crgmakes/kicad-library/models/PinHeader_2x02_P1.27mm_Vertical_SMD.step

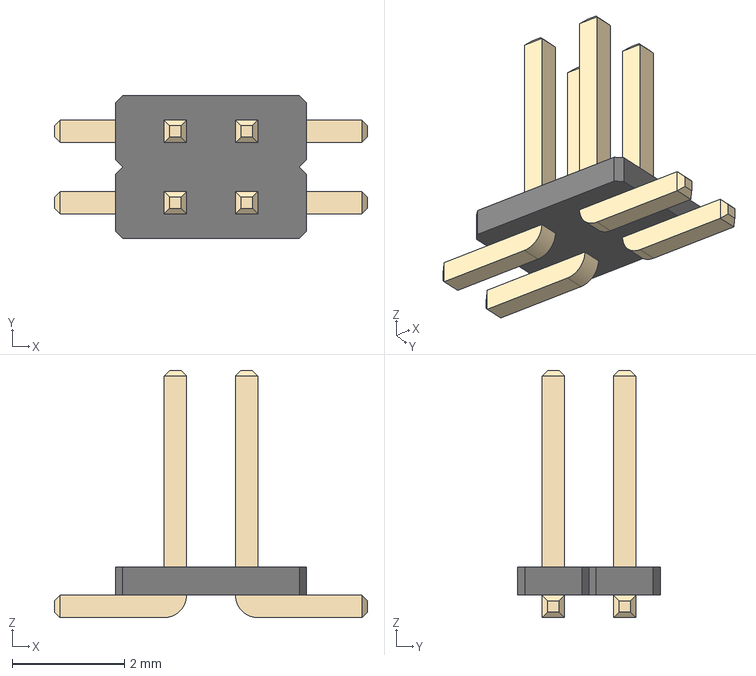
[picture p10: CAD file, 2026-08-05]
models/PinHeader_2x02_P1.27mm_Vertical_SMD.step
5.57 x 2.54 x 4.40 mm
