crgmakes/kicad-library/models/C_1210_3225Metric.step

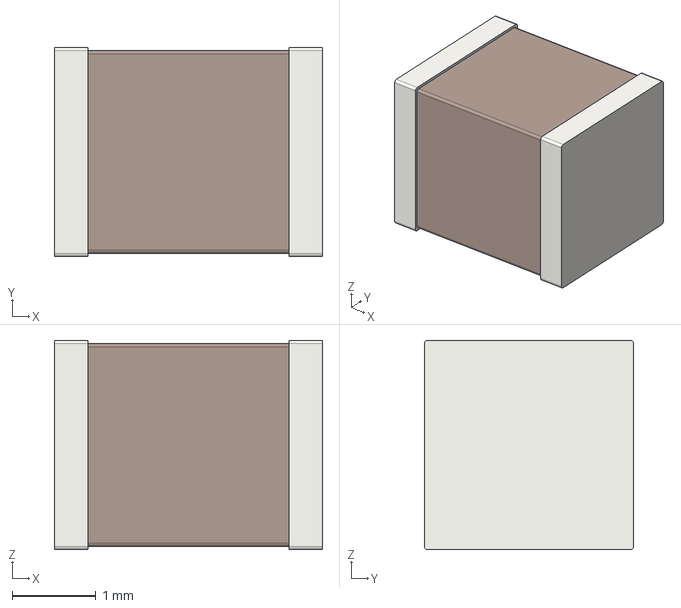
[picture p11: CAD file, 2026-07-14]
models/C_1210_3225Metric.step
3.20 x 2.50 x 2.50 mm
