crgmakes/kicad-library/models/C_0402_1005Metric.step

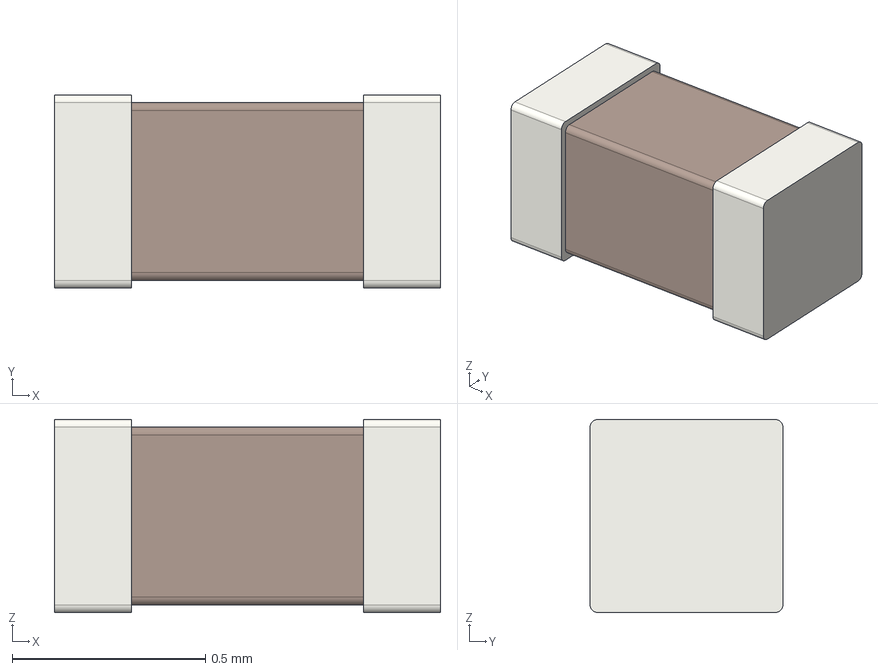
[picture p12: CAD file, 2026-07-14]
models/C_0402_1005Metric.step
1.00 x 0.5 x 0.5 mm
