crgmakes/kicad-library/models/C_0805_2012Metric.step

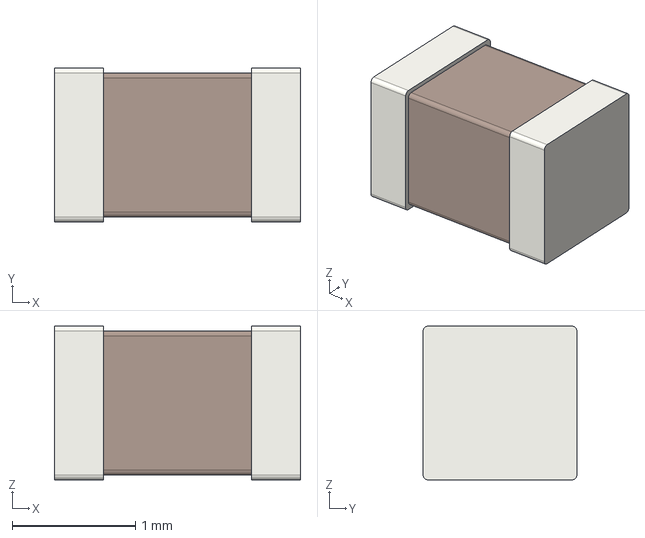
[picture p13: CAD file, 2026-07-14]
models/C_0805_2012Metric.step
2.00 x 1.25 x 1.25 mm
