crgmakes/kicad-library/models/SOIC-14_3.9x8.7mm_P1.27mm.step

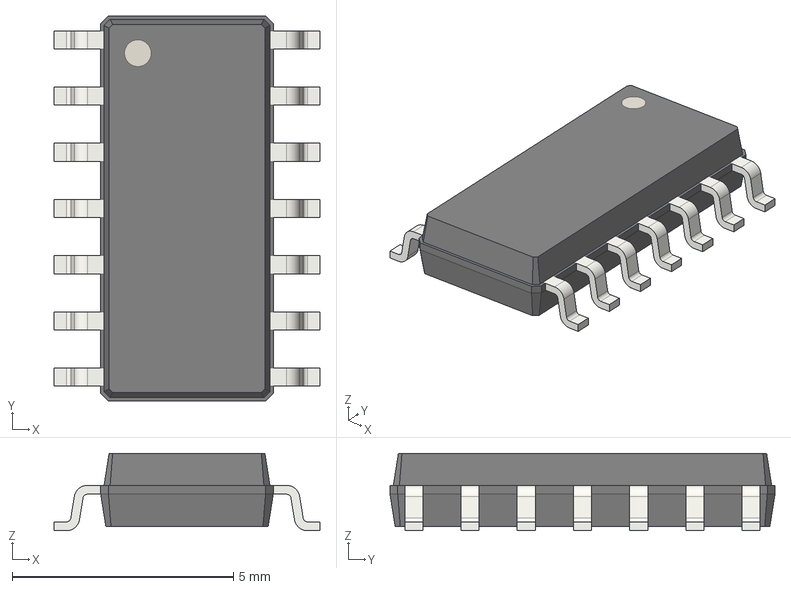
[picture p14: CAD file, 2026-06-17]
models/SOIC-14_3.9x8.7mm_P1.27mm.step
6.00 x 8.70 x 1.75 mm
