crgmakes/kicad-library/models/D_SOD-323F.step

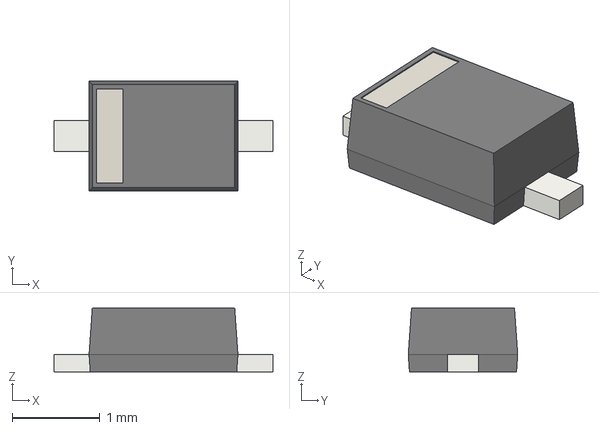
[picture p15: CAD file, 2026-06-17]
models/D_SOD-323F.step
2.50 x 1.25 x 0.73 mm
