crgmakes/kicad-library/models/Crystal_SMD_2016-4Pin_2.0x1.6mm.step

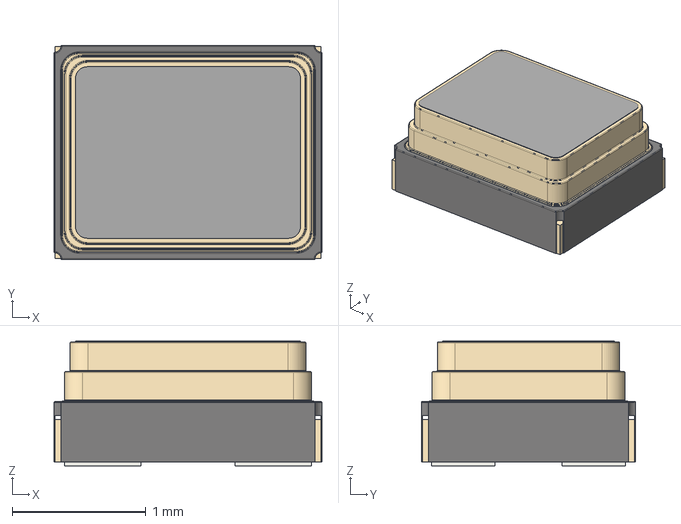
[picture p16: CAD file, 2026-06-13]
models/Crystal_SMD_2016-4Pin_2.0x1.6mm.step
2.00 x 1.60 x 0.93 mm
