crgmakes/kicad-library/models/ECS-480-8-47-JTN-TR.step

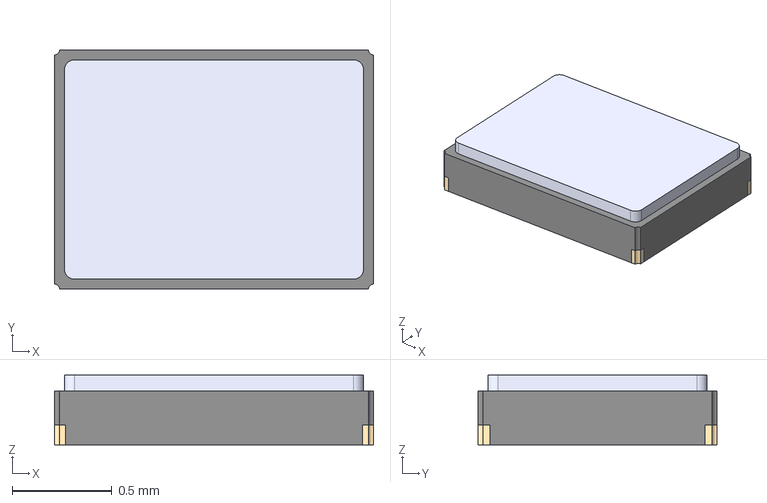
[picture p17: CAD file, 2026-06-13]
models/ECS-480-8-47-JTN-TR.step
1.60 x 1.20 x 0.35 mm
