crgmakes/kicad-library/models/STM32C031G4U6.step

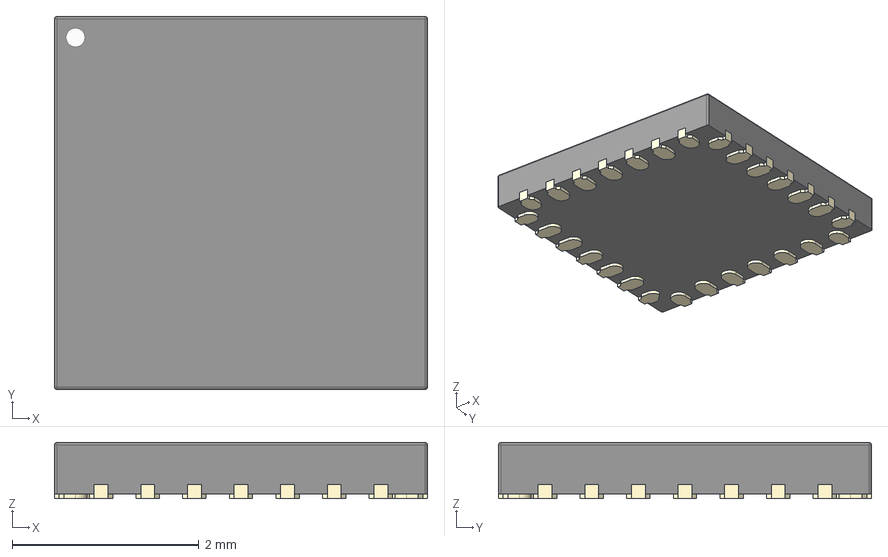
[picture p18: CAD file, 2026-06-13]
models/STM32C031G4U6.step
4.00 x 4.00 x 0.601 mm
