crgmakes/kicad-library/models/JST_SH_BM09B-SRSS-TB_1x09-1MP_P1.00mm_Vertical.step

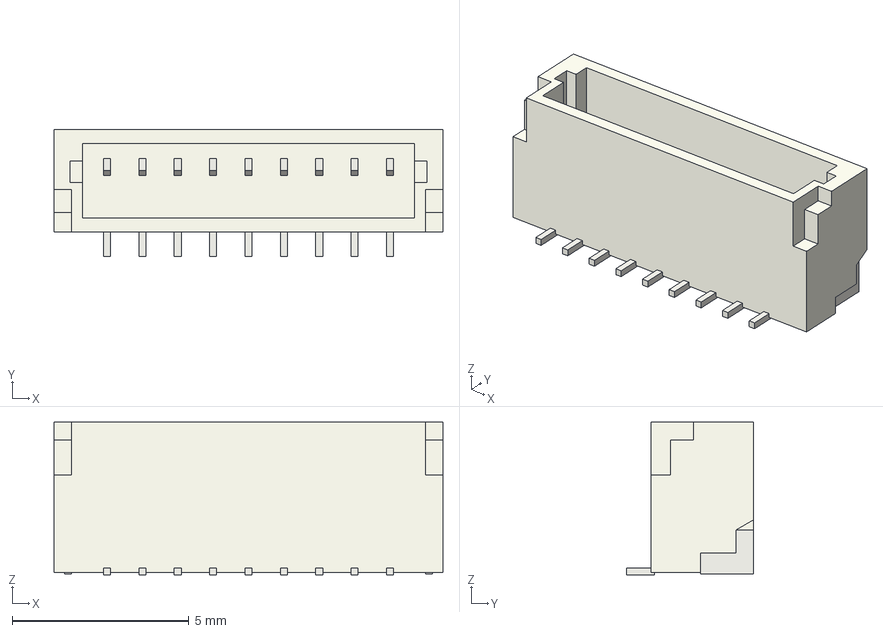
[picture p19: CAD file, 2026-06-10]
models/JST_SH_BM09B-SRSS-TB_1x09-1MP_P1.00mm_Vertical.step
11.0 x 3.60 x 4.32 mm
