crgmakes/kicad-library/models/LED_0603_1608Metric.step

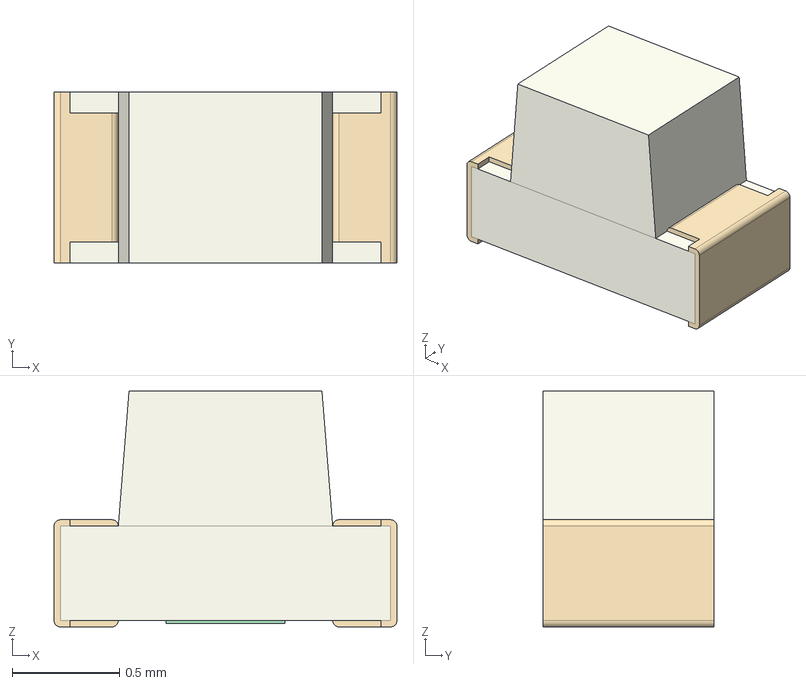
[picture p20: CAD file, 2026-06-10]
models/LED_0603_1608Metric.step
1.60 x 0.8 x 1.10 mm
