crgmakes/kicad-library/models/JST_SH_SM02B-SRSS-TB_1x02-1MP_P1.00mm_Horizontal.step

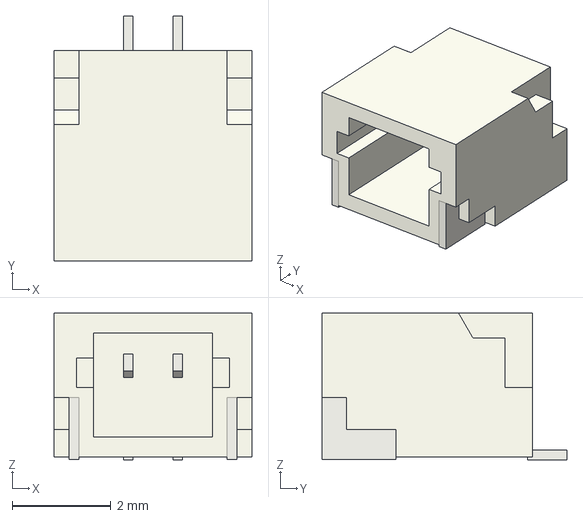
[picture p21: CAD file, 2026-06-10]
models/JST_SH_SM02B-SRSS-TB_1x02-1MP_P1.00mm_Horizontal.step
4.00 x 4.95 x 2.96 mm
