crgmakes/kicad-library/models/PinHeader_2x05_P2.54mm_Vertical.step

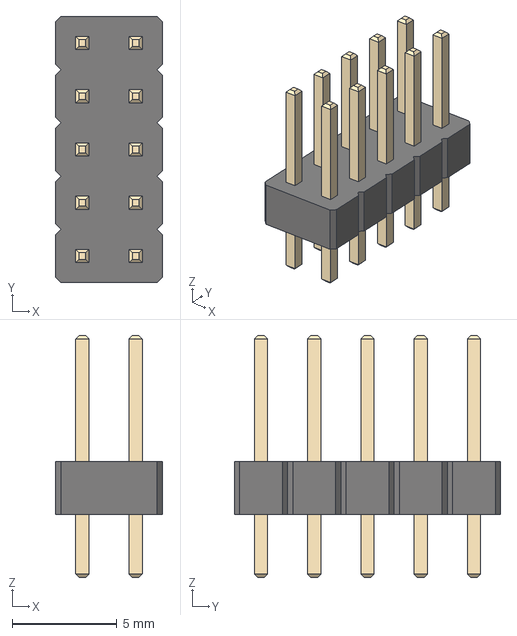
[picture p22: CAD file, 2026-06-10]
models/PinHeader_2x05_P2.54mm_Vertical.step
5.08 x 12.7 x 11.5 mm
