crgmakes/kicad-library/models/JST_SH_SM08B-SRSS-TB_1x08-1MP_P1.00mm_Horizontal.step

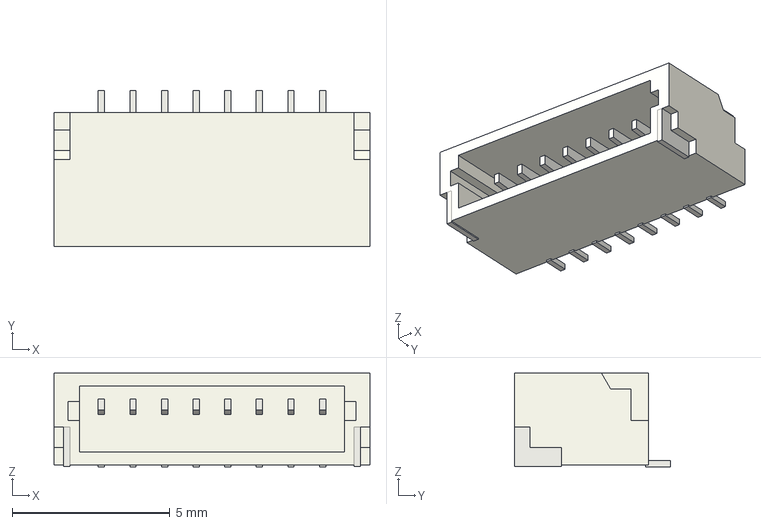
[picture p23: CAD file, 2026-06-10]
models/JST_SH_SM08B-SRSS-TB_1x08-1MP_P1.00mm_Horizontal.step
10.0 x 4.95 x 2.96 mm
