crgmakes/kicad-library/models/JST_SH_SM12B-SRSS-TB_1x12-1MP_P1.00mm_Horizontal.step

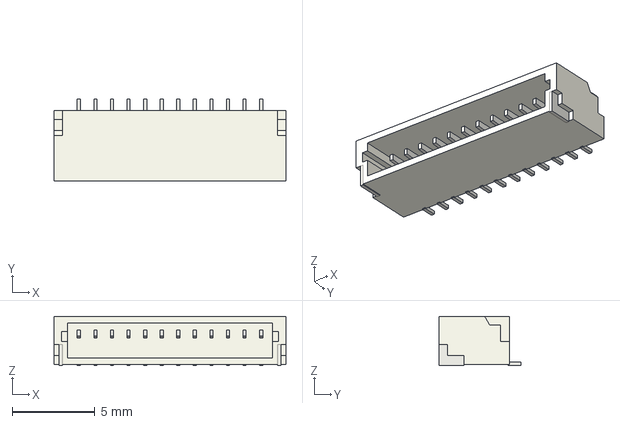
[picture p24: CAD file, 2026-06-10]
models/JST_SH_SM12B-SRSS-TB_1x12-1MP_P1.00mm_Horizontal.step
14.0 x 4.95 x 2.96 mm
