crgmakes/kicad-library/models/PinHeader_2x05_P1.27mm_Vertical.step

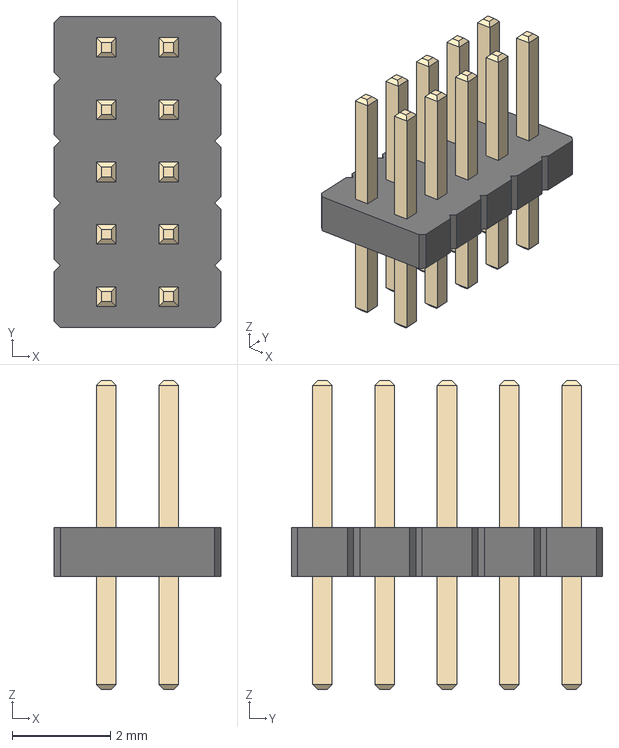
[picture p25: CAD file, 2026-06-10]
models/PinHeader_2x05_P1.27mm_Vertical.step
3.40 x 6.35 x 6.30 mm
