crgmakes/kicad-library/models/JST_SH_SM10B-SRSS-TB_1x10-1MP_P1.00mm_Horizontal.step

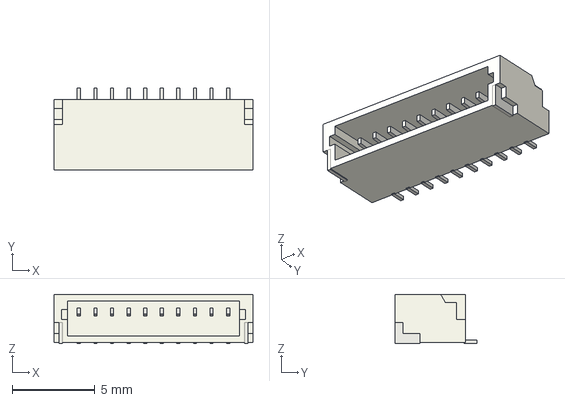
[picture p26: CAD file, 2026-06-10]
models/JST_SH_SM10B-SRSS-TB_1x10-1MP_P1.00mm_Horizontal.step
12.0 x 4.95 x 2.96 mm
