crgmakes/kicad-library/models/JST_SH_SM14B-SRSS-TB_1x14-1MP_P1.00mm_Horizontal.step

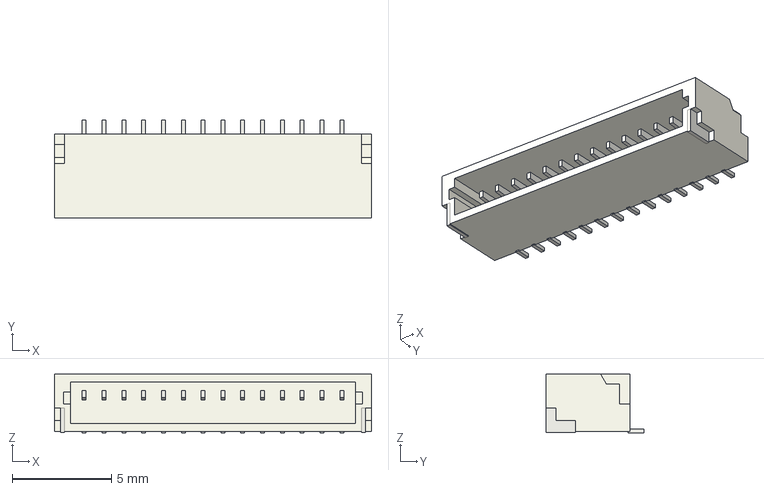
[picture p27: CAD file, 2026-06-10]
models/JST_SH_SM14B-SRSS-TB_1x14-1MP_P1.00mm_Horizontal.step
16.0 x 4.95 x 2.96 mm
