crgmakes/kicad-library/models/JST_SH_SM09B-SRSS-TB_1x09-1MP_P1.00mm_Horizontal.step

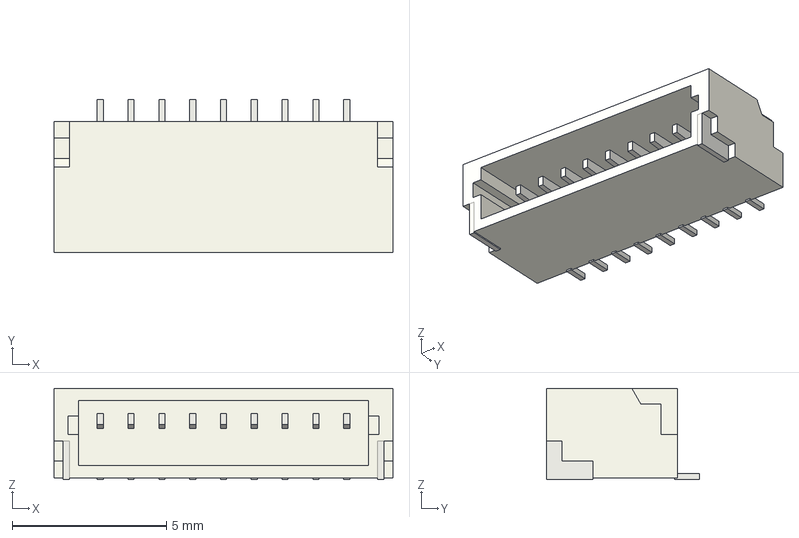
[picture p29: CAD file, 2026-06-10]
models/JST_SH_SM09B-SRSS-TB_1x09-1MP_P1.00mm_Horizontal.step
11.0 x 4.95 x 2.96 mm
