crgmakes/kicad-library/models/R_0603_1608Metric.step

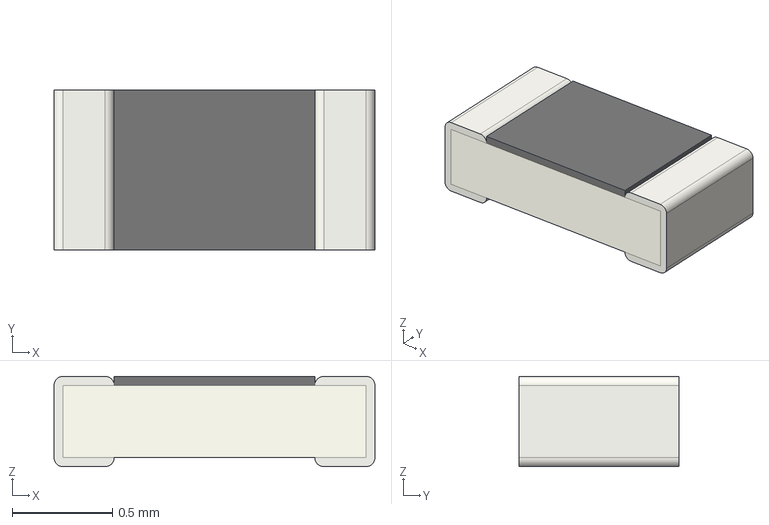
[picture p30: CAD file, 2026-06-10]
models/R_0603_1608Metric.step
1.60 x 0.8 x 0.45 mm
