crgmakes/kicad-library/models/JST_SH_BM06B-SRSS-TB_1x06-1MP_P1.00mm_Vertical.step

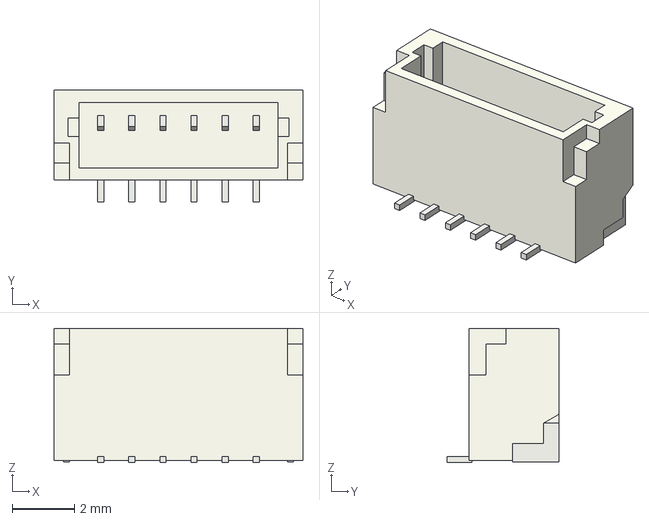
[picture p31: CAD file, 2026-06-10]
models/JST_SH_BM06B-SRSS-TB_1x06-1MP_P1.00mm_Vertical.step
8.00 x 3.60 x 4.32 mm
