crgmakes/kicad-library/models/PinHeader_2x05_P1.27mm_Vertical_SMD.step

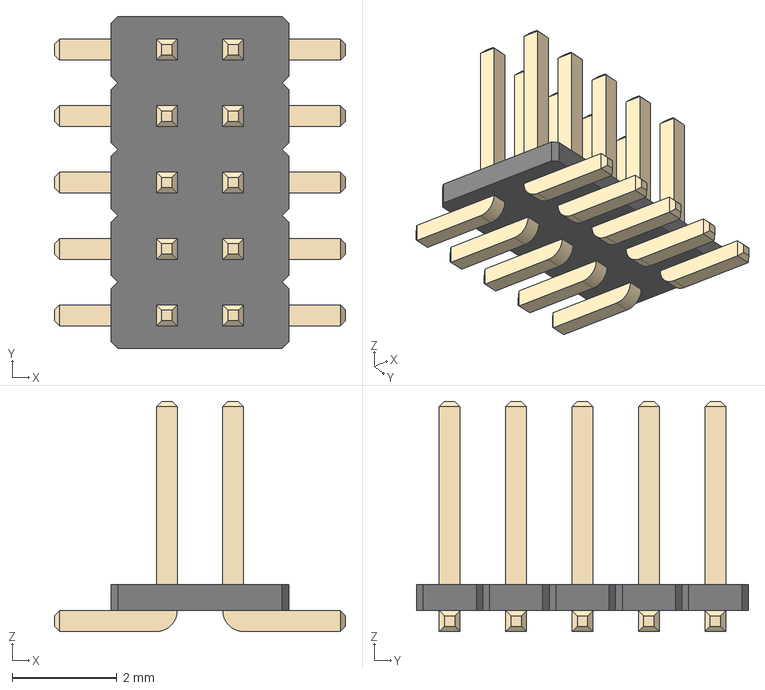
[picture p32: CAD file, 2026-06-10]
models/PinHeader_2x05_P1.27mm_Vertical_SMD.step
5.57 x 6.35 x 4.40 mm
