crgmakes/kicad-library/models/JST_SH_BM05B-SRSS-TB_1x05-1MP_P1.00mm_Vertical.step

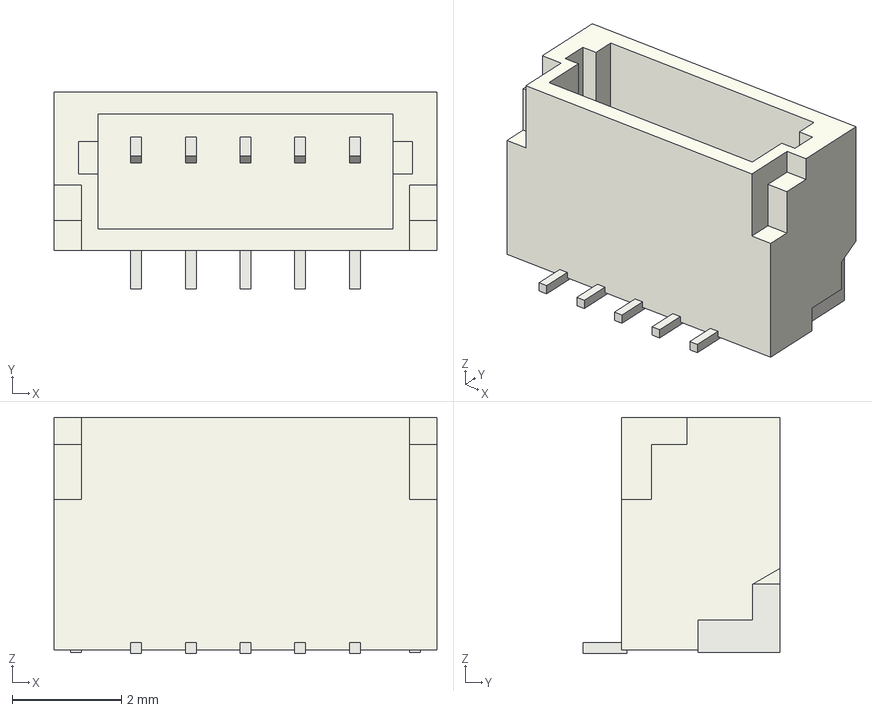
[picture p33: CAD file, 2026-06-10]
models/JST_SH_BM05B-SRSS-TB_1x05-1MP_P1.00mm_Vertical.step
7.00 x 3.60 x 4.32 mm
