crgmakes/kicad-library/models/CP_Elec_5x5.4.step

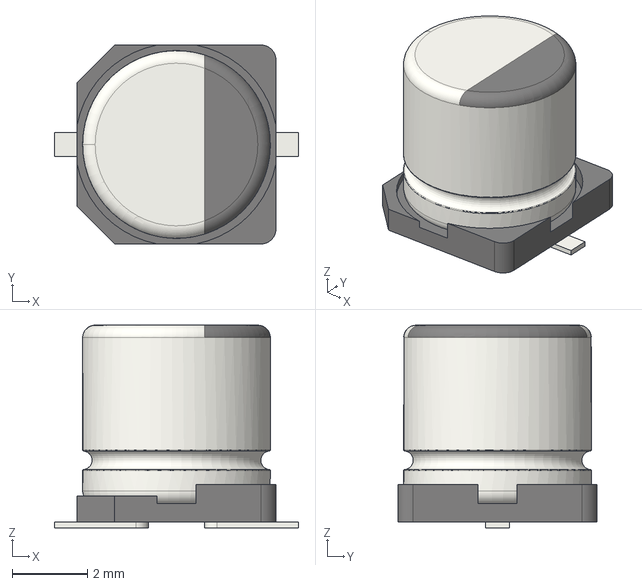
[picture p34: CAD file, 2026-06-10]
models/CP_Elec_5x5.4.step
6.50 x 5.30 x 5.40 mm
