crgmakes/kicad-library/models/PinHeader_2x05_P2.54mm_Vertical_SMD.step

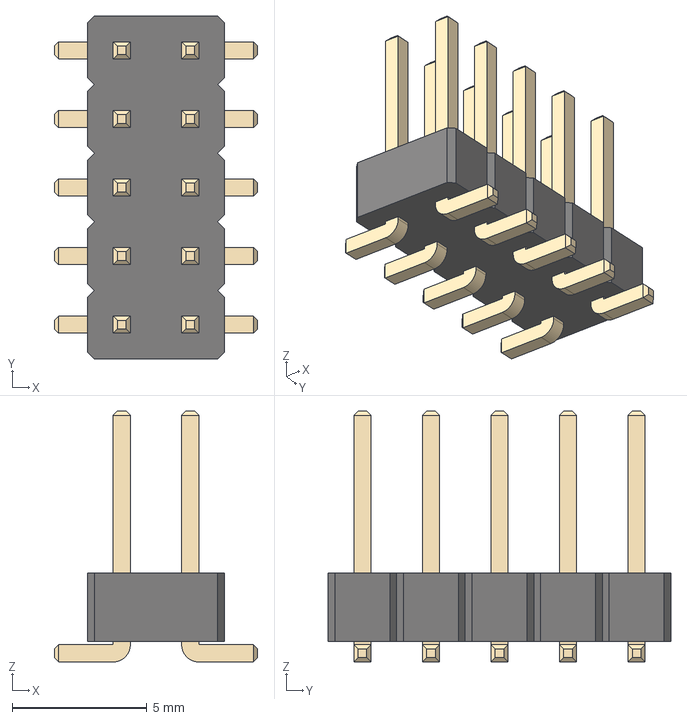
[picture p35: CAD file, 2026-06-10]
models/PinHeader_2x05_P2.54mm_Vertical_SMD.step
7.54 x 12.7 x 9.30 mm
