crgmakes/kicad-library/models/JST_SH_BM10B-SRSS-TB_1x10-1MP_P1.00mm_Vertical.step

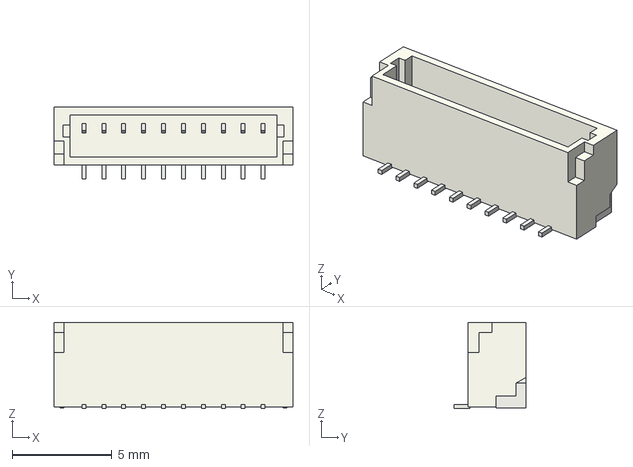
[picture p36: CAD file, 2026-06-10]
models/JST_SH_BM10B-SRSS-TB_1x10-1MP_P1.00mm_Vertical.step
12.0 x 3.60 x 4.32 mm
