crgmakes/kicad-library/models/C_0603_1608Metric.step

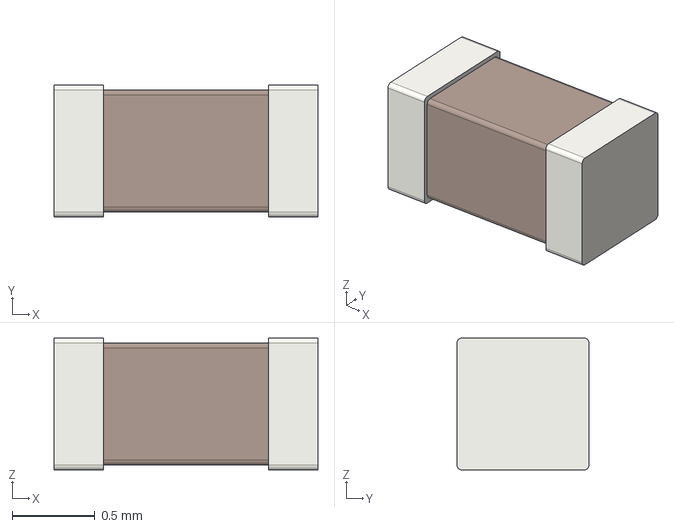
[picture p37: CAD file, 2026-06-10]
models/C_0603_1608Metric.step
1.60 x 0.8 x 0.8 mm
