crgmakes/kicad-library/models/JST_SH_BM04B-SRSS-TB_1x04-1MP_P1.00mm_Vertical.step

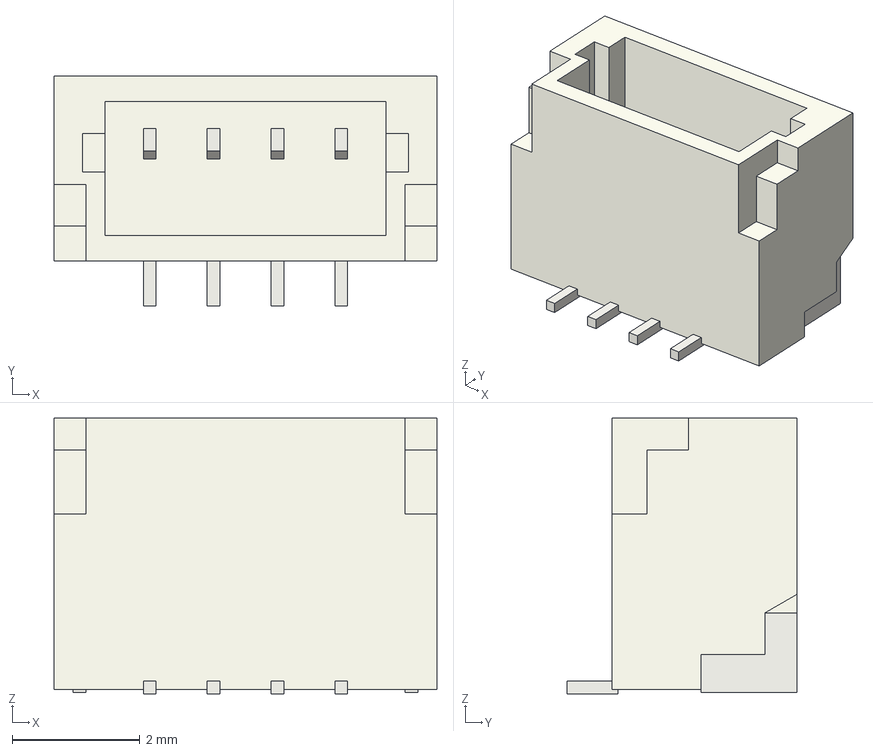
[picture p38: CAD file, 2026-06-10]
models/JST_SH_BM04B-SRSS-TB_1x04-1MP_P1.00mm_Vertical.step
6.00 x 3.60 x 4.32 mm
