crgmakes/kicad-library/models/PinHeader_2x03_P2.54mm_Vertical.step

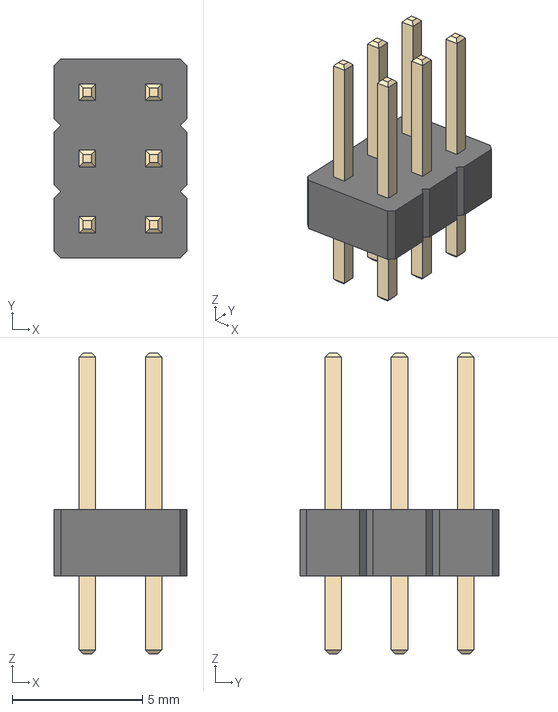
[picture p39: CAD file, 2026-06-10]
models/PinHeader_2x03_P2.54mm_Vertical.step
5.08 x 7.62 x 11.5 mm
