crgmakes/kicad-library/models/JST_SH_SM07B-SRSS-TB_1x07-1MP_P1.00mm_Horizontal.step

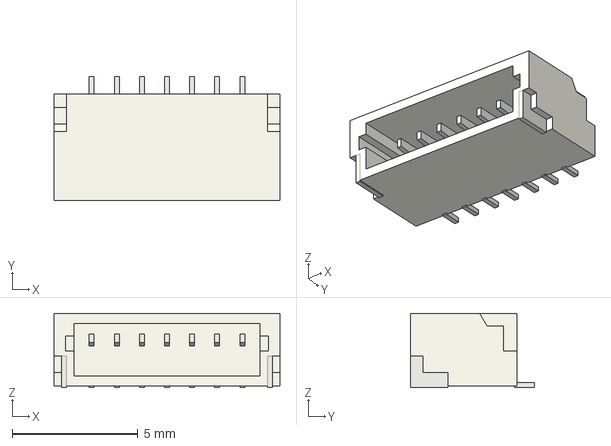
[picture p40: CAD file, 2026-06-10]
models/JST_SH_SM07B-SRSS-TB_1x07-1MP_P1.00mm_Horizontal.step
9.00 x 4.95 x 2.96 mm
