crgmakes/kicad-library/models/JST_SH_BM11B-SRSS-TB_1x11-1MP_P1.00mm_Vertical.step

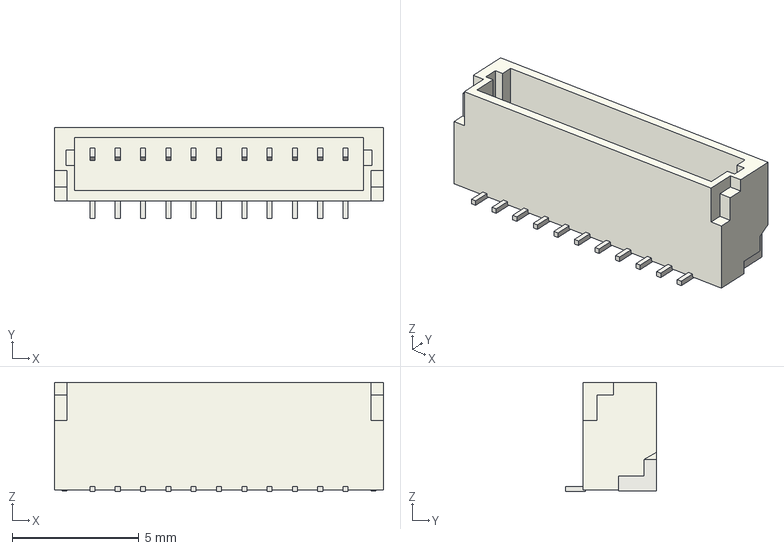
[picture p41: CAD file, 2026-06-10]
models/JST_SH_BM11B-SRSS-TB_1x11-1MP_P1.00mm_Vertical.step
13.0 x 3.60 x 4.32 mm
