crgmakes/kicad-library/models/JST_SH_BM02B-SRSS-TB_1x02-1MP_P1.00mm_Vertical.step

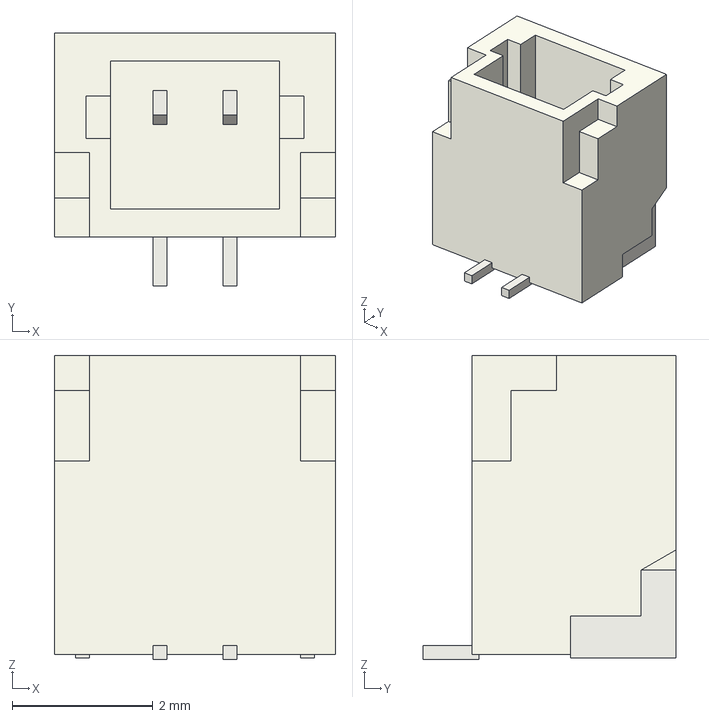
[picture p42: CAD file, 2026-06-10]
models/JST_SH_BM02B-SRSS-TB_1x02-1MP_P1.00mm_Vertical.step
4.00 x 3.60 x 4.32 mm
