crgmakes/kicad-library/models/JST_SH_SM15B-SRSS-TB_1x15-1MP_P1.00mm_Horizontal.step

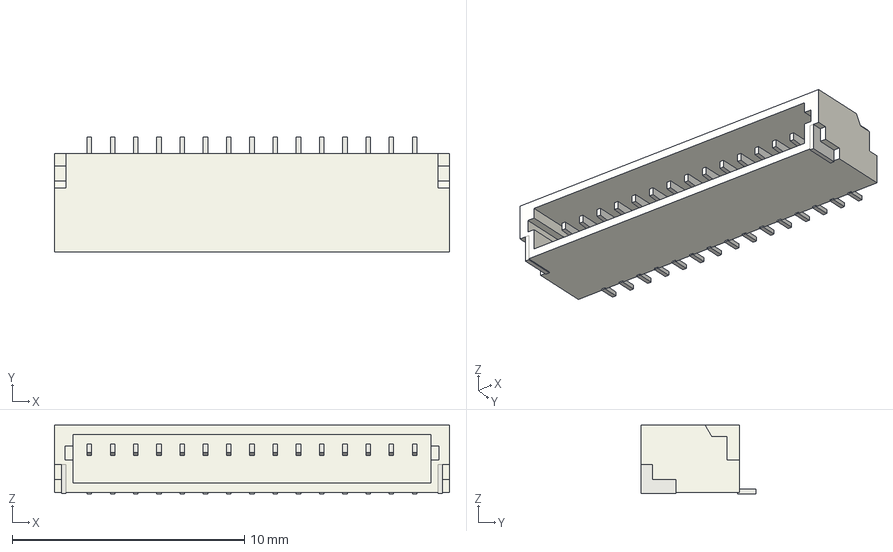
[picture p44: CAD file, 2026-06-10]
models/JST_SH_SM15B-SRSS-TB_1x15-1MP_P1.00mm_Horizontal.step
17.0 x 4.95 x 2.96 mm
