crgmakes/kicad-library/models/JST_SH_BM13B-SRSS-TB_1x13-1MP_P1.00mm_Vertical.step

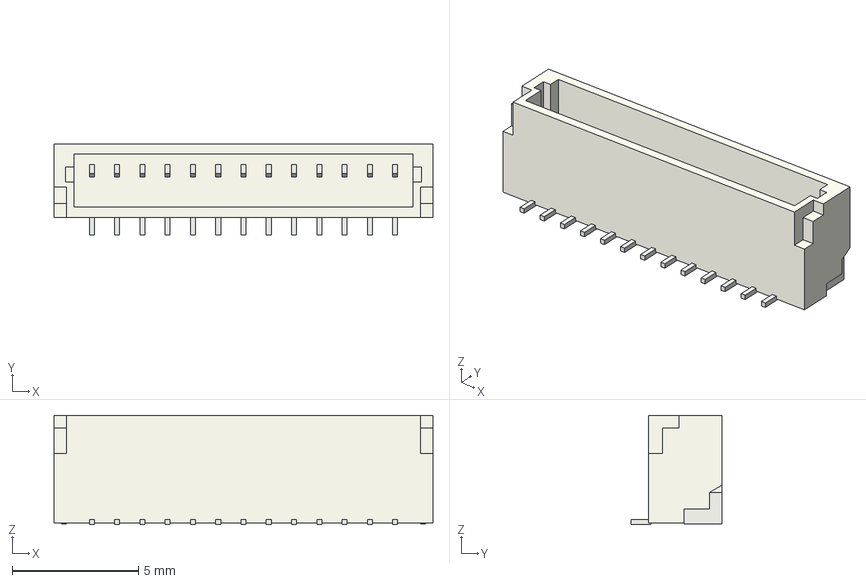
[picture p45: CAD file, 2026-06-10]
models/JST_SH_BM13B-SRSS-TB_1x13-1MP_P1.00mm_Vertical.step
15.0 x 3.60 x 4.32 mm
