crgmakes/kicad-library/models/PinHeader_2x05_P1.27mm_Horizontal.step

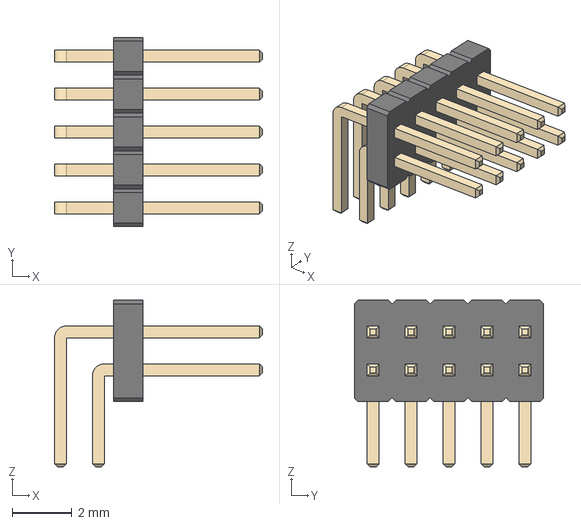
[picture p48: CAD file, 2026-06-10]
models/PinHeader_2x05_P1.27mm_Horizontal.step
6.97 x 6.35 x 5.58 mm
