crgmakes/kicad-library/models/C_1206_3216Metric.step

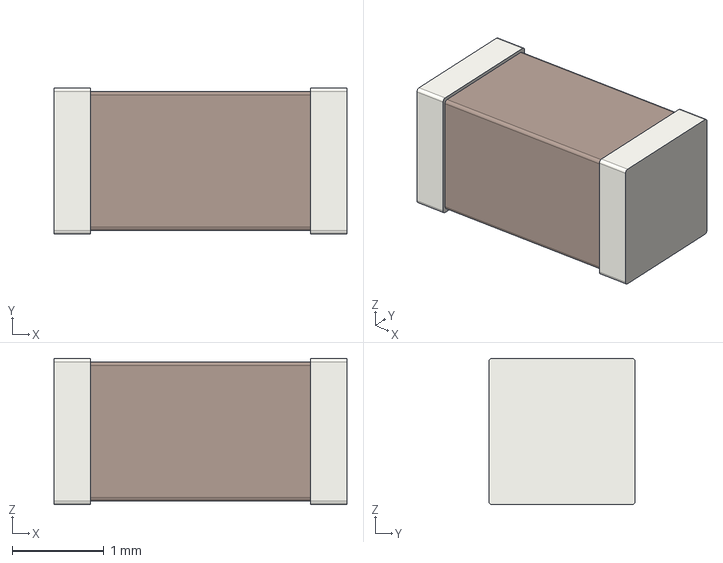
[picture p51: CAD file, 2026-06-10]
models/C_1206_3216Metric.step
3.20 x 1.60 x 1.60 mm
