crgmakes/kicad-library/models/JST_SH_SM13B-SRSS-TB_1x13-1MP_P1.00mm_Horizontal.step

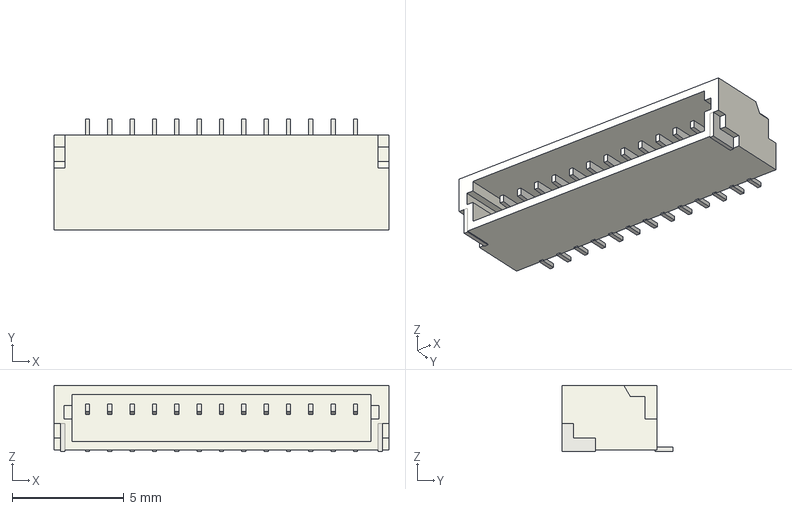
[picture p52: CAD file, 2026-06-10]
models/JST_SH_SM13B-SRSS-TB_1x13-1MP_P1.00mm_Horizontal.step
15.0 x 4.95 x 2.96 mm
