crgmakes/kicad-library/models/JST_SH_BM12B-SRSS-TB_1x12-1MP_P1.00mm_Vertical.step

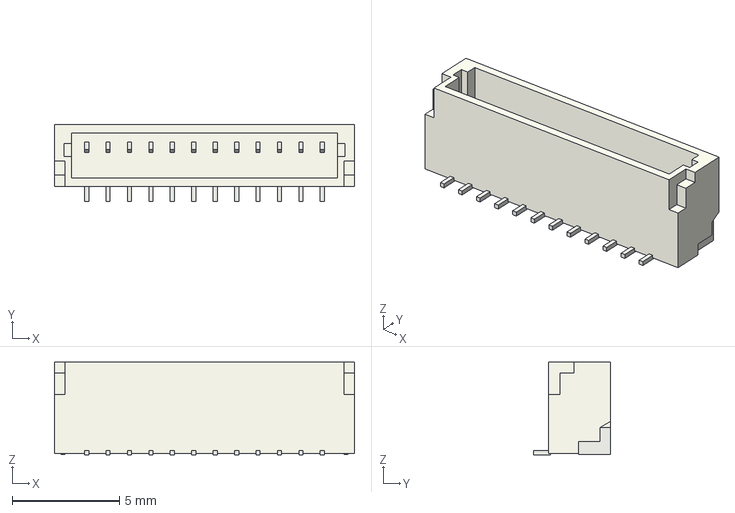
[picture p53: CAD file, 2026-06-10]
models/JST_SH_BM12B-SRSS-TB_1x12-1MP_P1.00mm_Vertical.step
14.0 x 3.60 x 4.32 mm
