crgmakes/kicad-library/models/JST_SH_BM08B-SRSS-TB_1x08-1MP_P1.00mm_Vertical.step

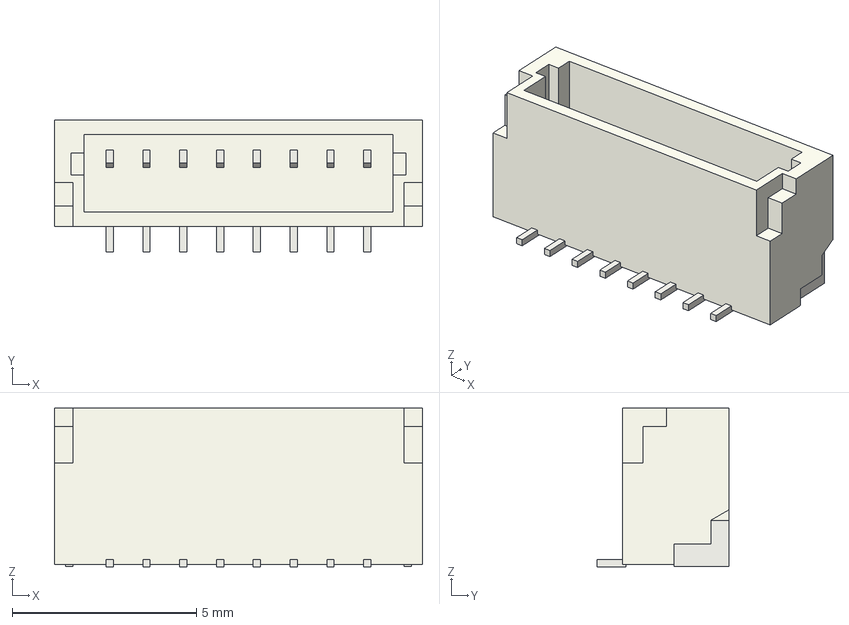
[picture p55: CAD file, 2026-06-10]
models/JST_SH_BM08B-SRSS-TB_1x08-1MP_P1.00mm_Vertical.step
10.0 x 3.60 x 4.32 mm
