crgmakes/kicad-library/models/CP_Elec_6.3x5.4.step

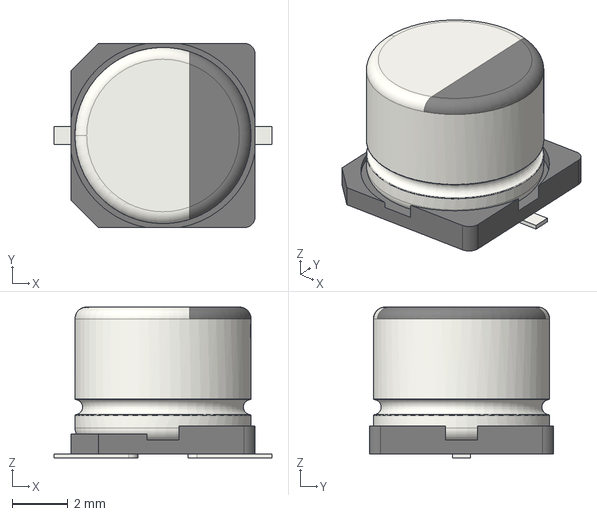
[picture p56: CAD file, 2026-06-10]
models/CP_Elec_6.3x5.4.step
7.80 x 6.60 x 5.40 mm
