crgmakes/kicad-library/models/PinHeader_2x03_P2.54mm_Horizontal.step

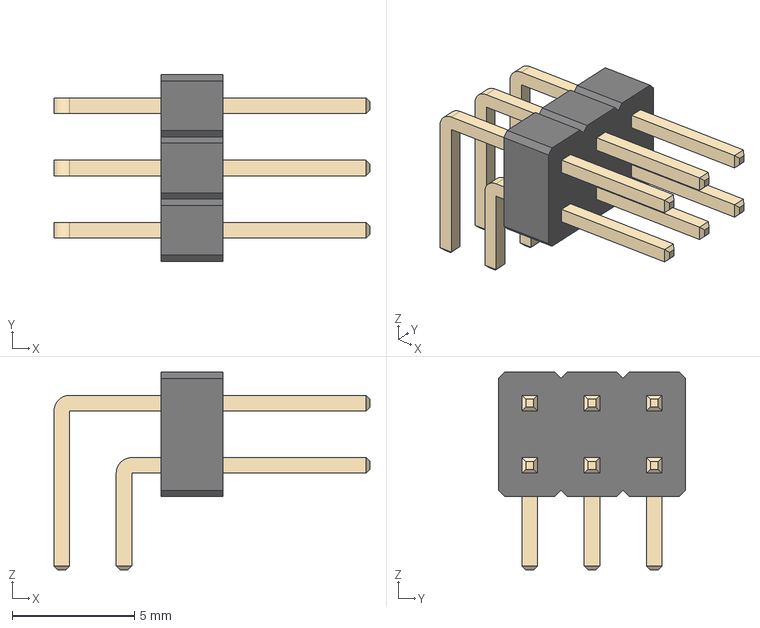
[picture p57: CAD file, 2026-06-10]
models/PinHeader_2x03_P2.54mm_Horizontal.step
12.9 x 7.62 x 8.08 mm
