crgmakes/kicad-library/models/JST_SH_BM07B-SRSS-TB_1x07-1MP_P1.00mm_Vertical.step

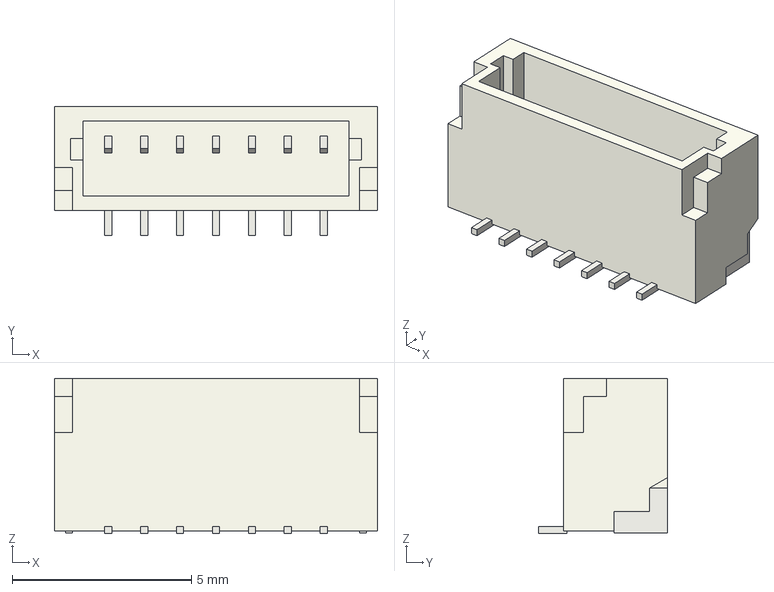
[picture p58: CAD file, 2026-06-10]
models/JST_SH_BM07B-SRSS-TB_1x07-1MP_P1.00mm_Vertical.step
9.00 x 3.60 x 4.32 mm
