crgmakes/kicad-library/models/PinHeader_2x05_P2.54mm_Horizontal.step

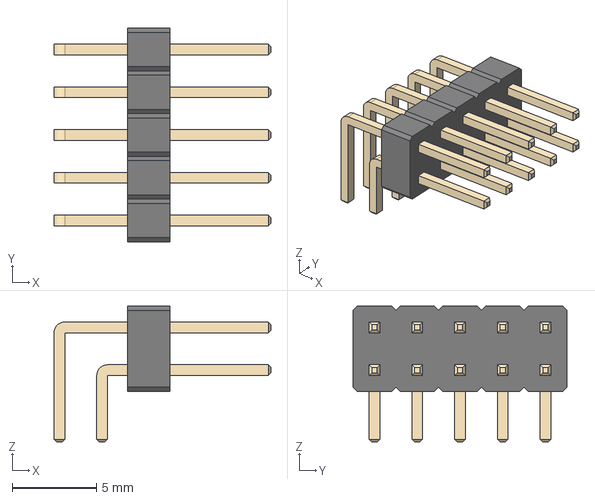
[picture p59: CAD file, 2026-06-10]
models/PinHeader_2x05_P2.54mm_Horizontal.step
12.9 x 12.7 x 8.08 mm
