crgmakes/kicad-library/models/D_SOD-882.step

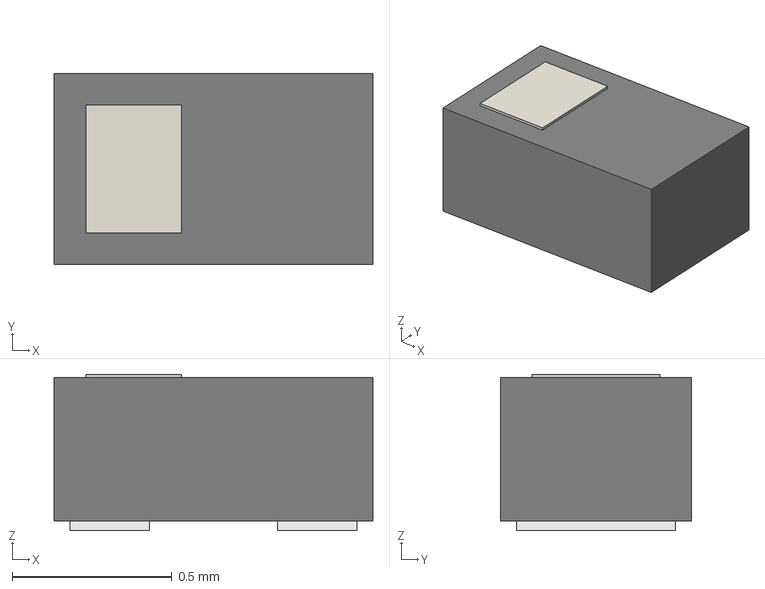
[picture p61: CAD file, 2026-06-10]
models/D_SOD-882.step
1.00 x 0.6 x 0.49 mm
