crgmakes/kicad-library/models/A1324LLHLT-T.step

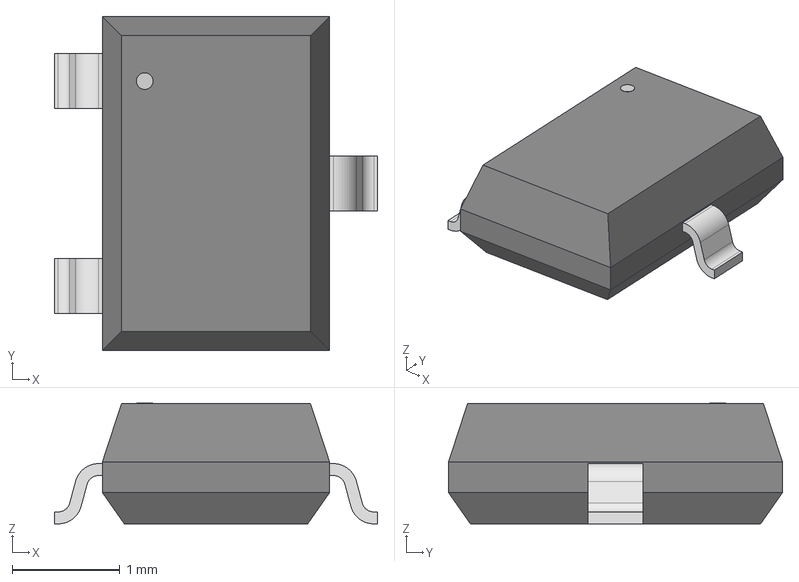
[picture p62: CAD file, 2026-03-20]
models/A1324LLHLT-T.step
3.00 x 3.10 x 1.12 mm
