crgmakes/kicad-library/models/SM02B-SRSS-TB.step

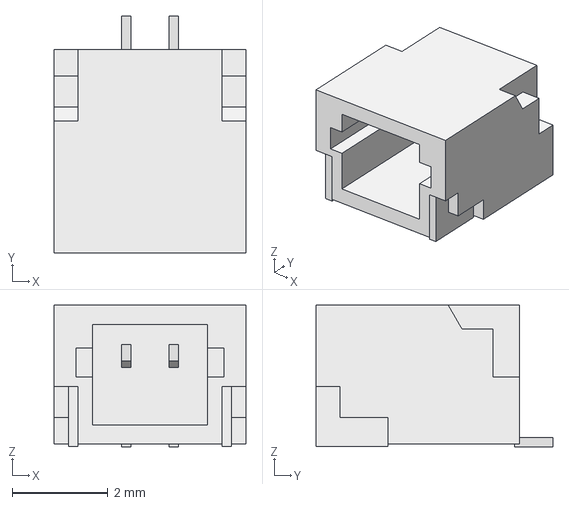
[picture p64: CAD file, 2026-01-01]
models/SM02B-SRSS-TB.step
4.00 x 4.95 x 2.96 mm
