crgmakes/kicad-library/models/BAT48JFILM.step

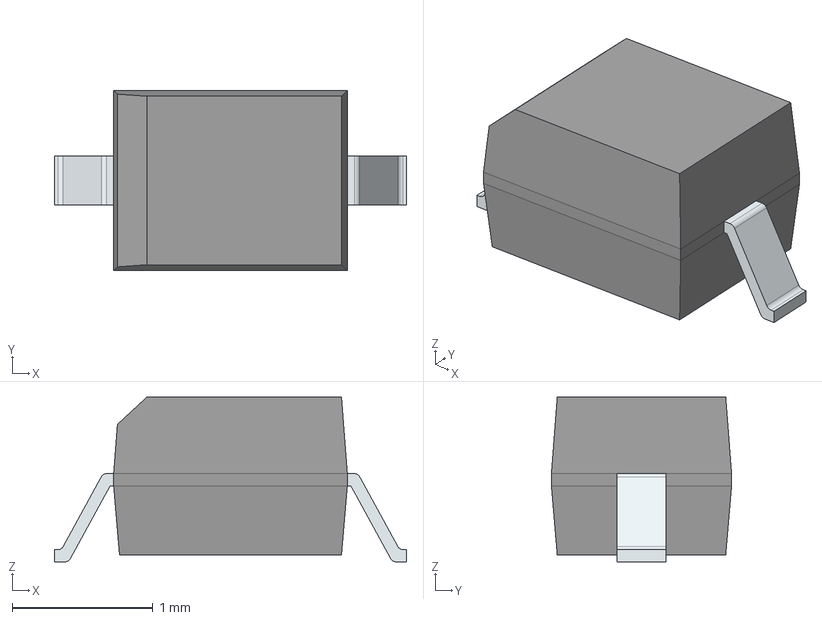
[picture p65: CAD file, 2025-11-04]
models/BAT48JFILM.step
2.50 x 1.28 x 1.17 mm
FilletPinL
FilletPinR
