crgmakes/kicad-library/models/AHT20.step

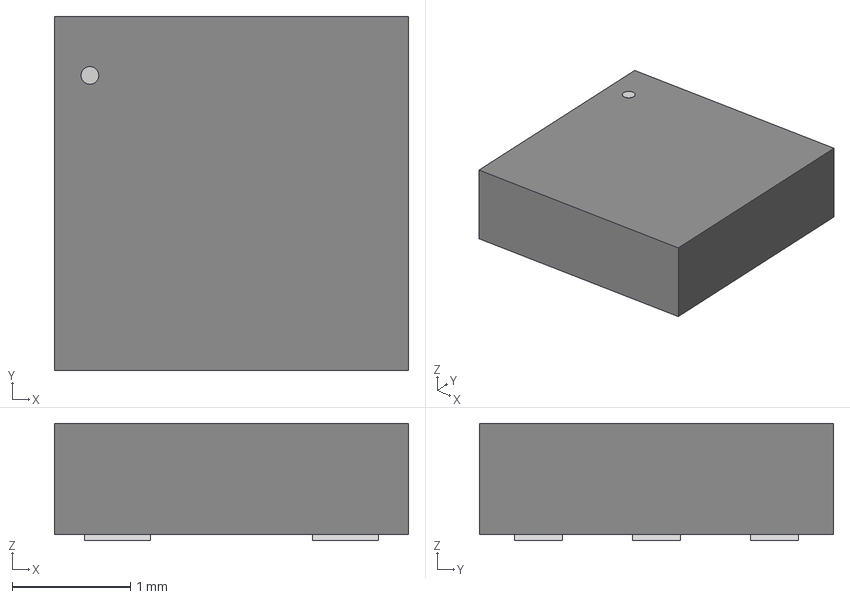
[picture p66: CAD file, 2025-11-04]
models/AHT20.step
3.00 x 3.00 x 0.993 mm
