crgmakes/kicad-library/models/SKRPABE010.step

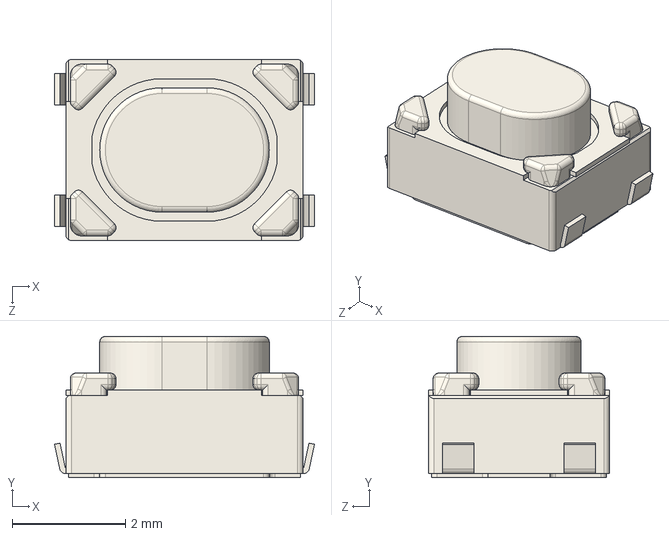
[picture p67: CAD file, 2025-10-28]
models/SKRPABE010.step
4.60 x 2.50 x 3.20 mm
