crgmakes/kicad-library/models/SOP65P640X110-20N.step

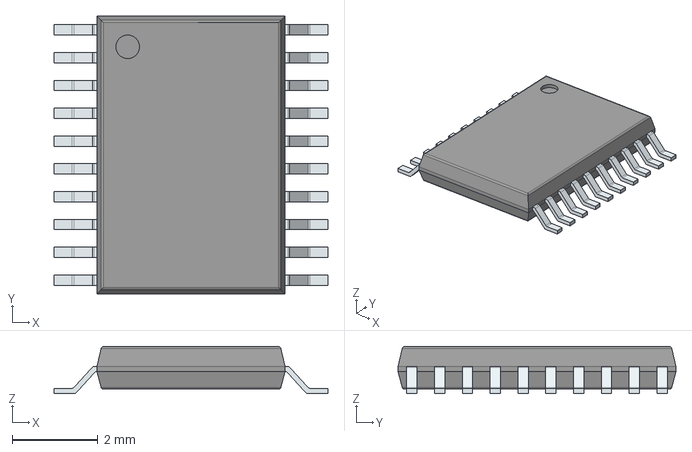
[picture p68: CAD file, 2025-10-24]
models/SOP65P640X110-20N.step
6.40 x 6.50 x 1.10 mm
PinsArrayLR
