crgmakes/kicad-library/models/STX883Pro.step

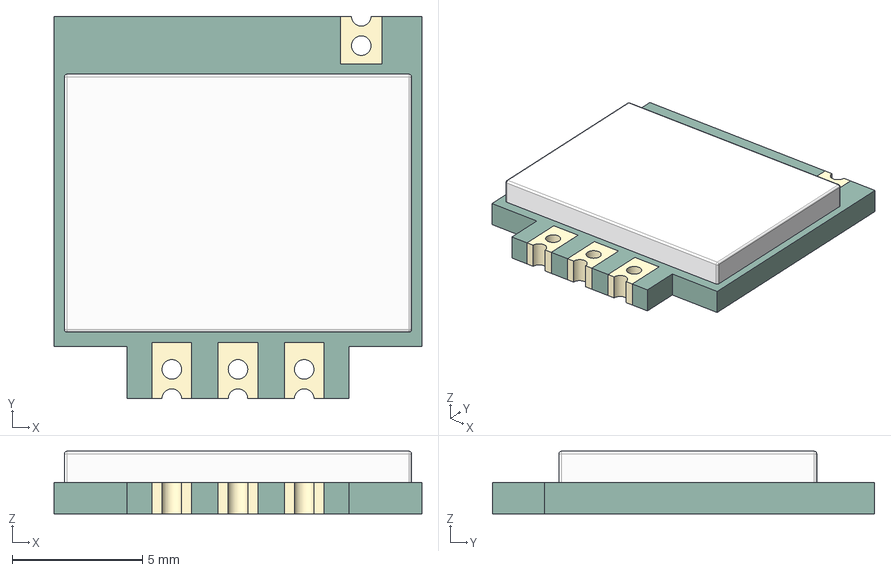
[picture p69: CAD file, 2025-08-31]
models/STX883Pro.step
14.1 x 14.7 x 2.40 mm
