crgmakes/kicad-library/models/SRX883Pro.step

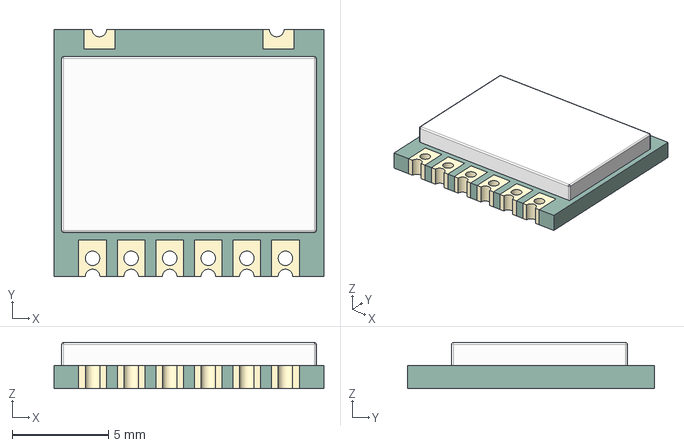
[picture p70: CAD file, 2025-08-31]
models/SRX883Pro.step
14.0 x 12.8 x 2.40 mm
