crgmakes/kicad-library/models/TO-252-3_6P6X6P1_DIO.step

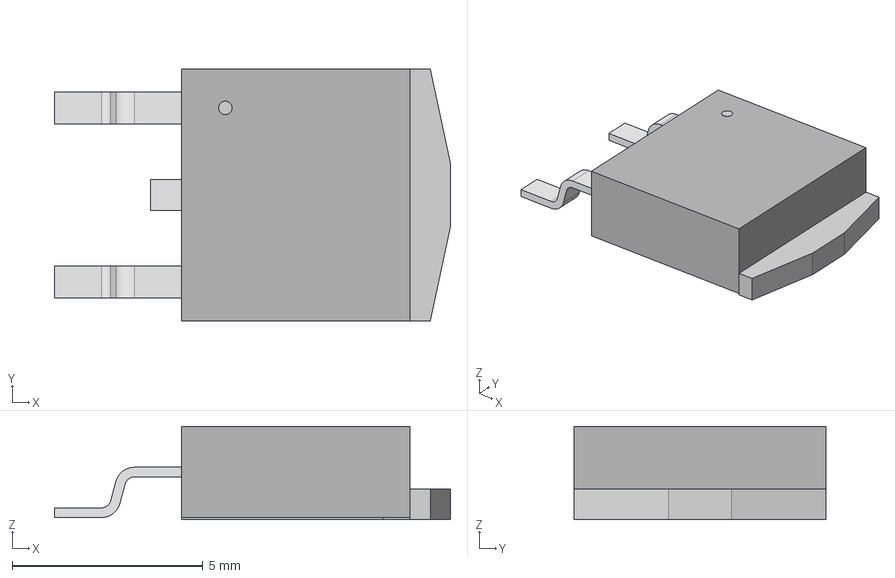
[picture p71: CAD file, 2025-08-31]
models/TO-252-3_6P6X6P1_DIO.step
10.4 x 6.60 x 2.44 mm
