crgmakes/kicad-library/models/USBLC6-2P6.step

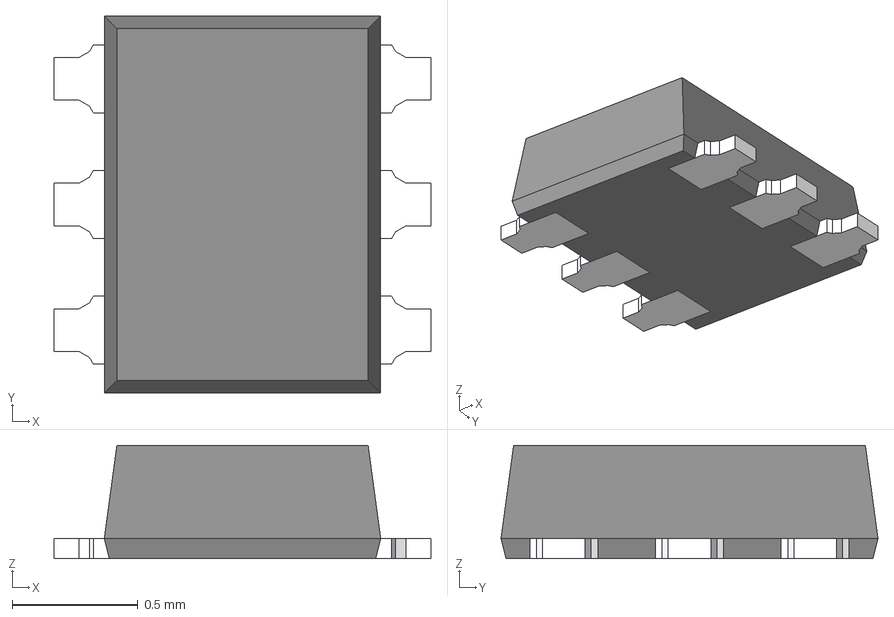
[picture p72: CAD file, 2025-08-26]
models/USBLC6-2P6.step
1.50 x 1.50 x 0.45 mm
