crgmakes/kicad-library/models/SM03B-SRSS-TB.step

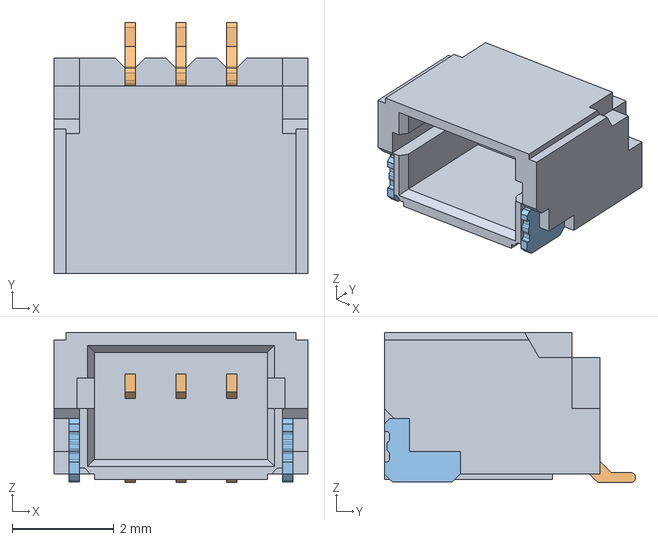
[picture p73: CAD file, 2025-08-16]
models/SM03B-SRSS-TB.step
5.00 x 4.95 x 2.96 mm
