crgmakes/kicad-library/models/TC33X-2-103E.step

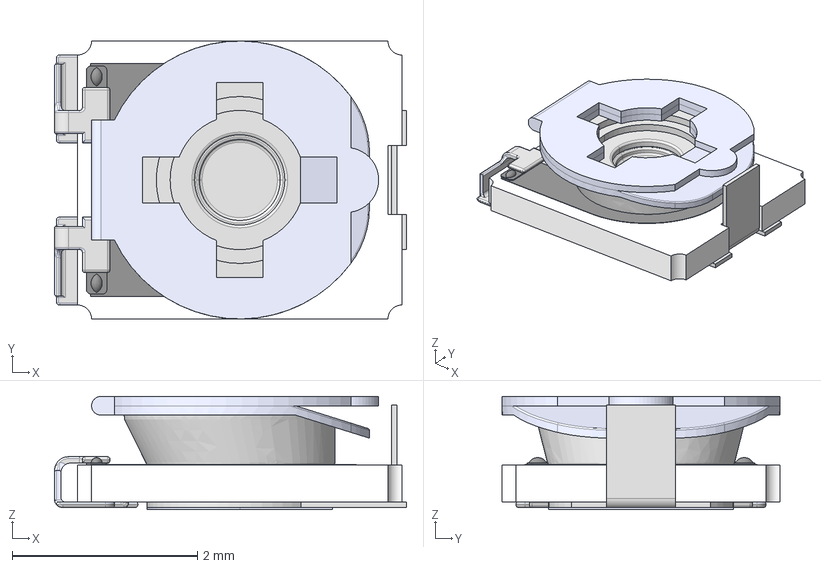
[picture p74: CAD file, 2025-08-15]
models/TC33X-2-103E.step
3.80 x 3.00 x 1.22 mm
