crgmakes/kicad-library/models/SGP40-D-R4.step

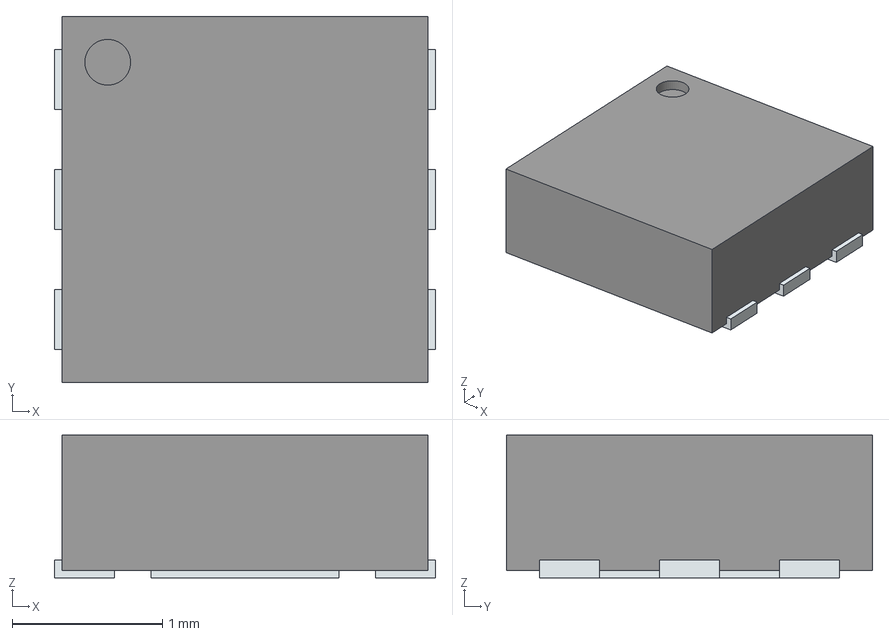
[picture p75: CAD file, 2025-08-12]
models/SGP40-D-R4.step
2.54 x 2.44 x 0.95 mm
ThermalPin
PinsArrayLR
