crgmakes/kicad-library/models/HDC1080DMBR.step

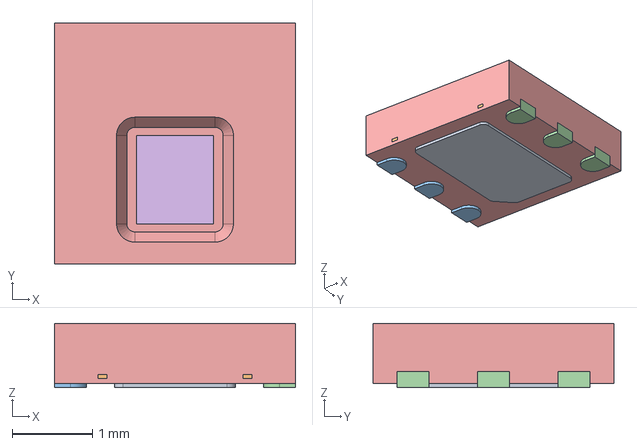
[picture p76: CAD file, 2025-08-11]
models/HDC1080DMBR.step
3.00 x 3.00 x 0.8 mm
