crgmakes/kicad-library/models/LD1117S33TR.step

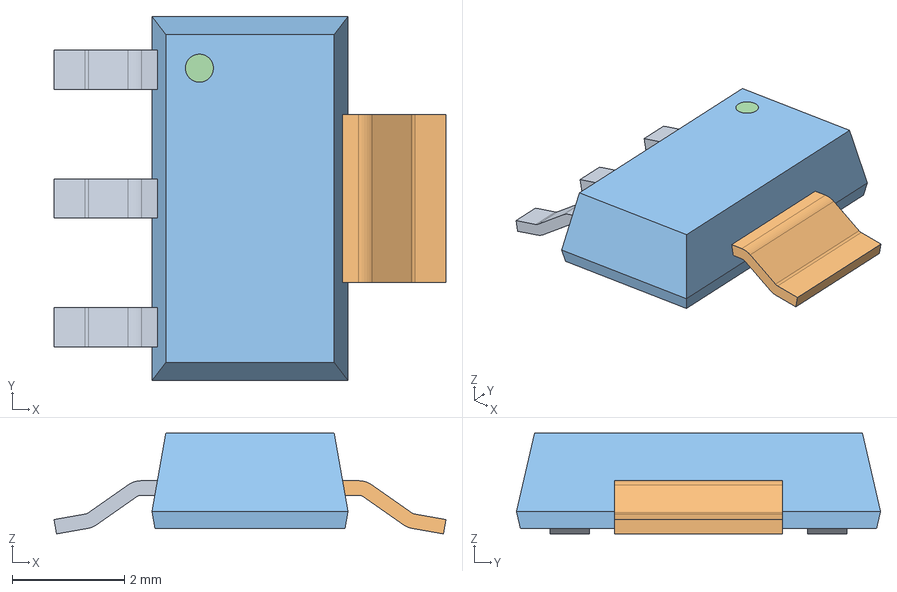
[picture p77: CAD file, 2025-08-11]
models/LD1117S33TR.step
7.00 x 6.50 x 1.80 mm
