crgmakes/kicad-library/models/LTR-303ALS-01.step

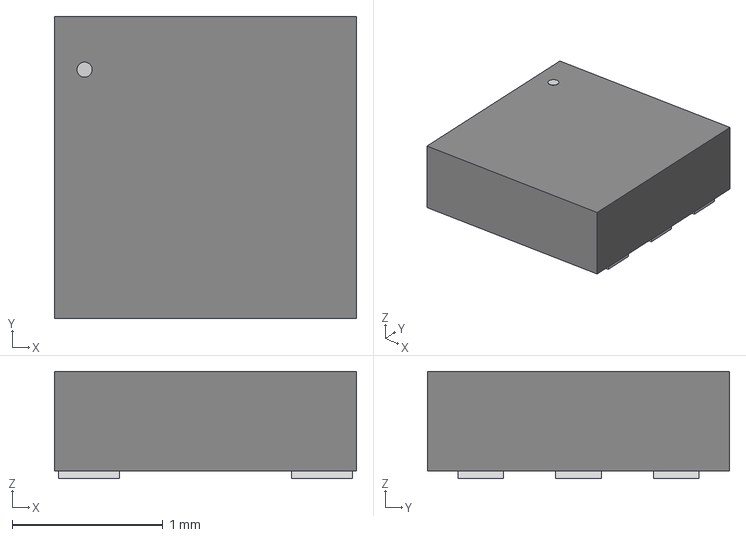
[picture p78: CAD file, 2025-07-12]
models/LTR-303ALS-01.step
2.01 x 2.01 x 0.714 mm
