crgmakes/kicad-library/models/BM08B-SRSS-TB.step

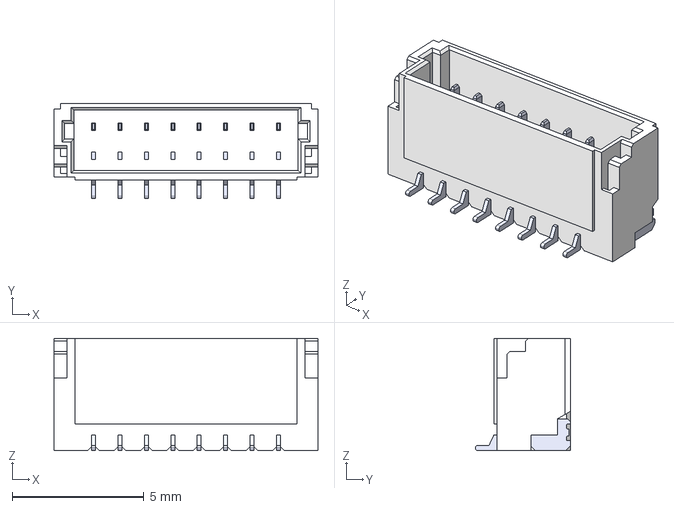
[picture p79: CAD file, 2025-06-02]
models/BM08B-SRSS-TB.step
10.0 x 3.60 x 4.25 mm
