crgmakes/kicad-library/models/BM06B-SRSS-TB.step

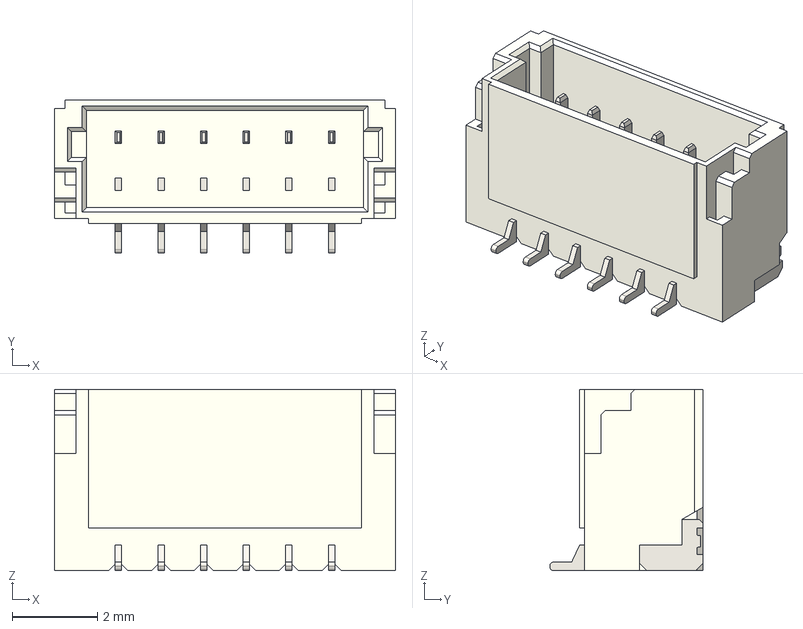
[picture p80: CAD file, 2025-06-02]
models/BM06B-SRSS-TB.step
8.00 x 3.60 x 4.25 mm
