crgmakes/kicad-library/models/MMBT2222AT-7-F.step

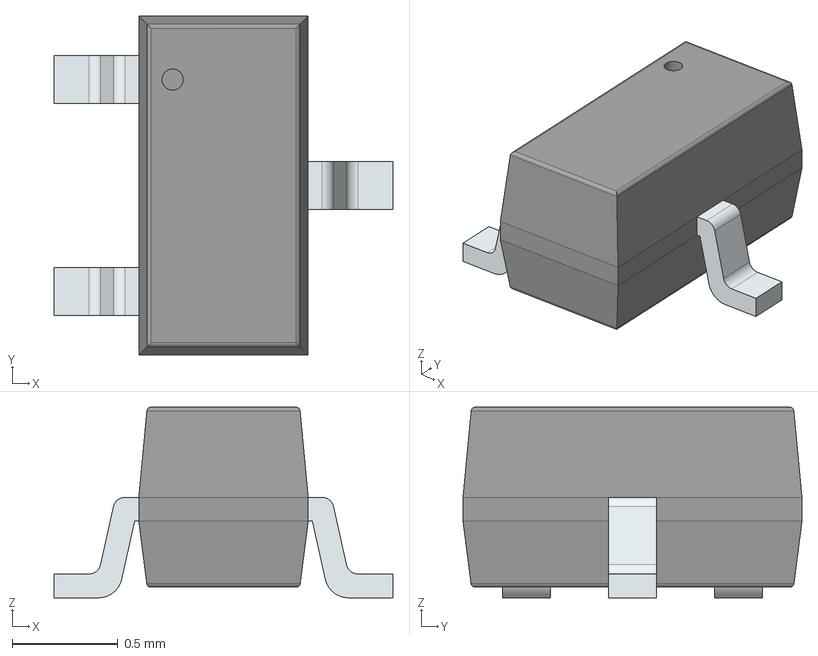
[picture p81: CAD file, 2025-06-02]
models/MMBT2222AT-7-F.step
1.60 x 1.60 x 0.9 mm
PinsArrayL
FilletPinR
