crgmakes/kicad-library/models/BM03B-SRSS-TB.step

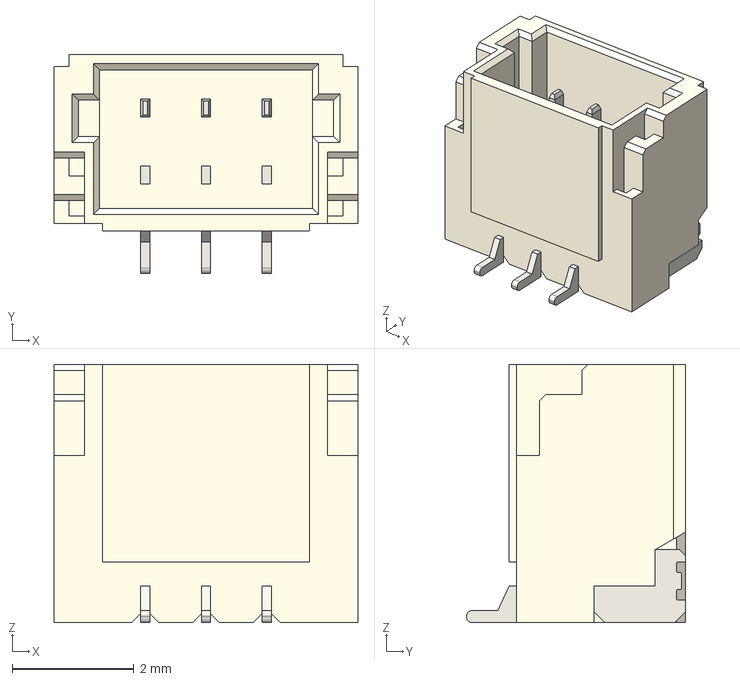
[picture p82: CAD file, 2025-06-02]
models/BM03B-SRSS-TB.step
5.00 x 3.60 x 4.25 mm
