crgmakes/kicad-library/models/IRM-10-5.step

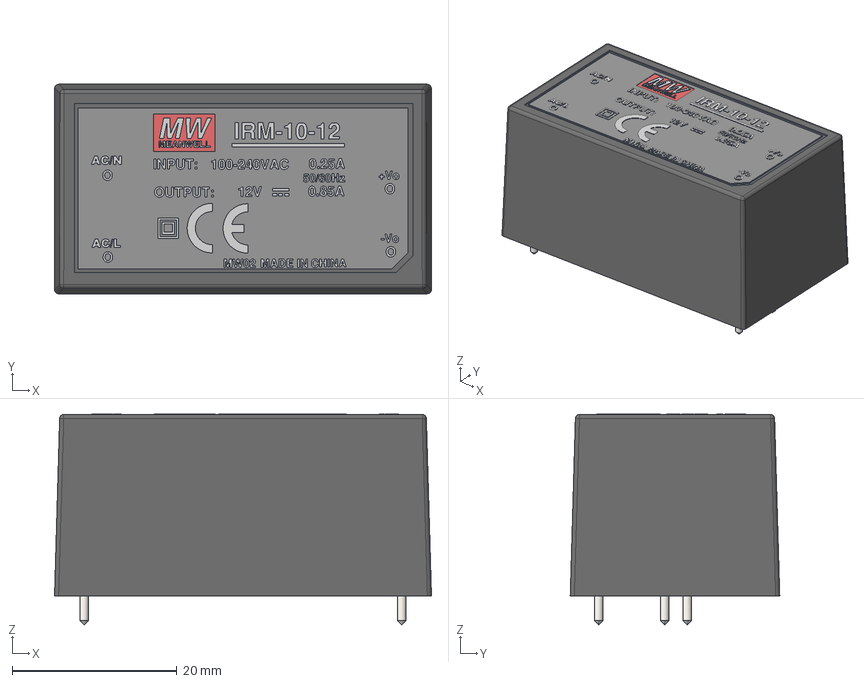
[picture p83: CAD file, 2025-05-20]
models/IRM-10-5.step
45.7 x 25.4 x 25.6 mm
