crgmakes/kicad-library/models/USB4105-GF-A-060.step

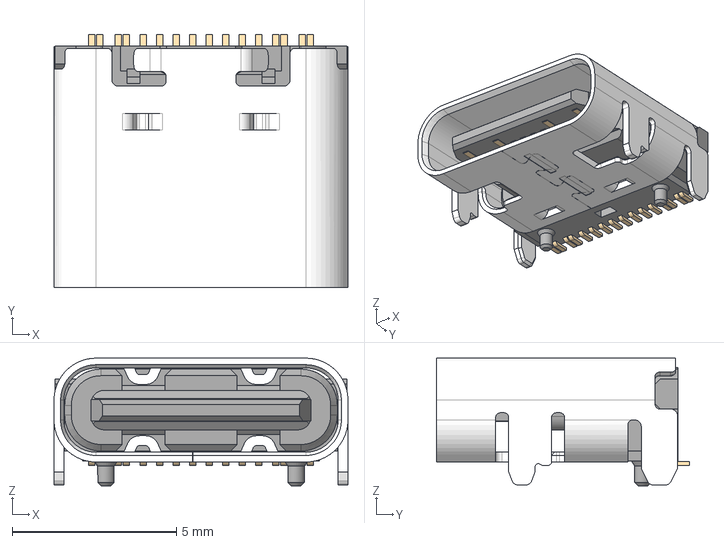
[picture p84: CAD file, 2025-05-20]
models/USB4105-GF-A-060.step
8.94 x 7.70 x 3.89 mm
