crgmakes/kicad-library/models/MOV-20D331K.step

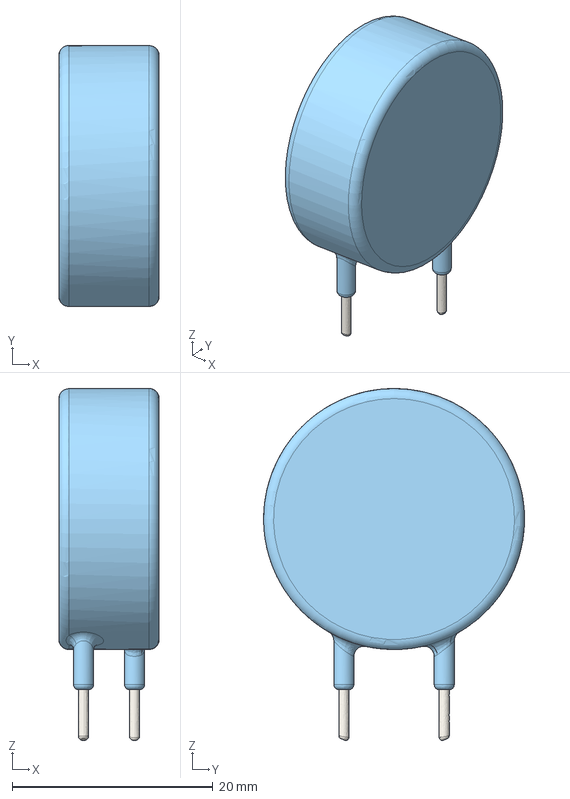
[picture p85: CAD file, 2025-05-17]
models/MOV-20D331K.step
10.0 x 26.0 x 35.1 mm
