crgmakes/kicad-library/models/EVQ-Q2B02W.step

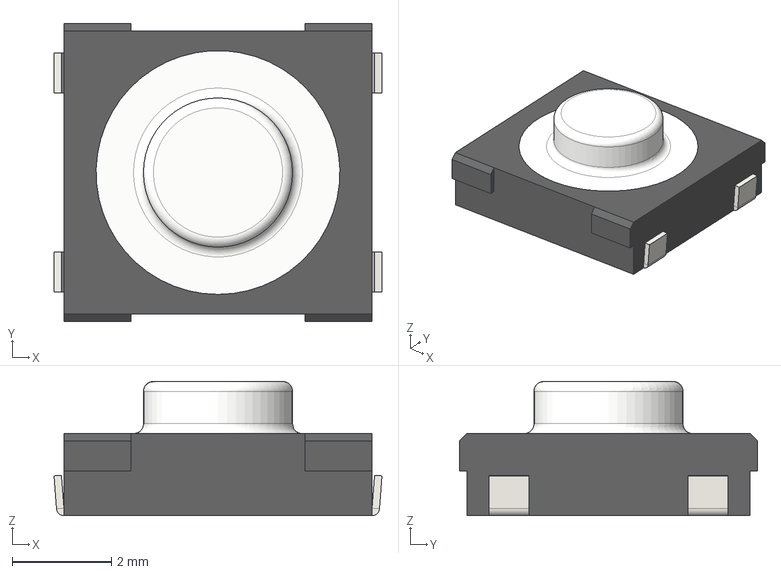
[picture p86: CAD file, 2025-05-17]
models/EVQ-Q2B02W.step
6.60 x 6.00 x 2.70 mm
