crgmakes/kicad-library/models/ESP32-S3-WROOM-1U-N4R2.step

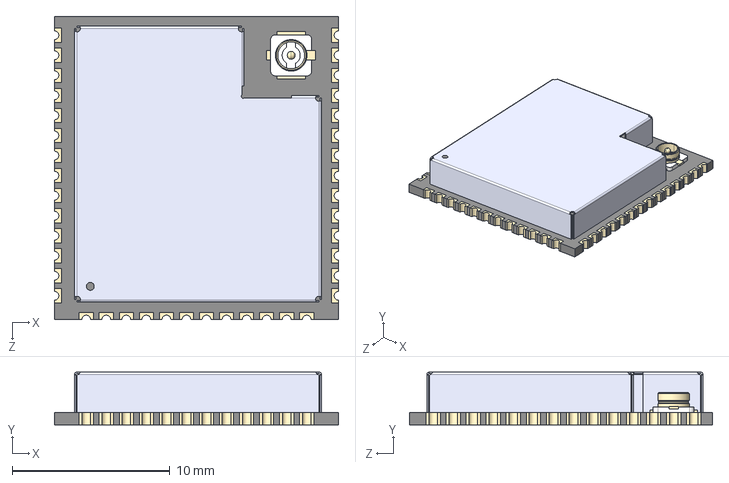
[picture p87: CAD file, 2025-05-17]
models/ESP32-S3-WROOM-1U-N4R2.step
18.0 x 3.35 x 19.2 mm
