crgmakes/kicad-library/models/PR24-5V-900-1A.step

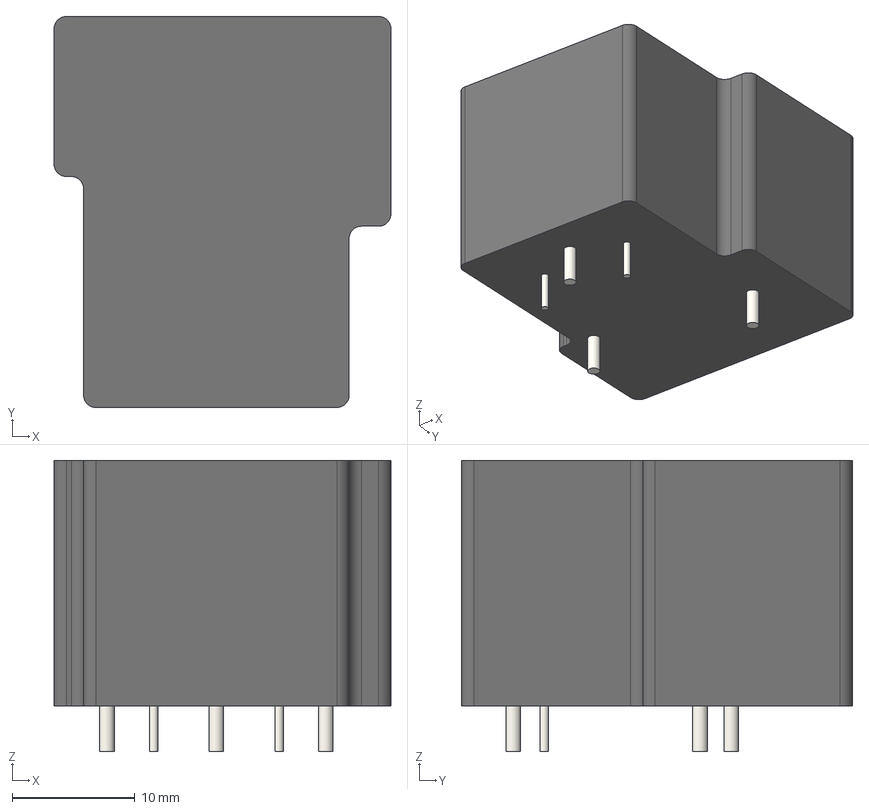
[picture p88: CAD file, 2025-05-17]
models/PR24-5V-900-1A.step
27.4 x 31.8 x 23.7 mm
