crgmakes/kicad-library/models/MMBT3904.step

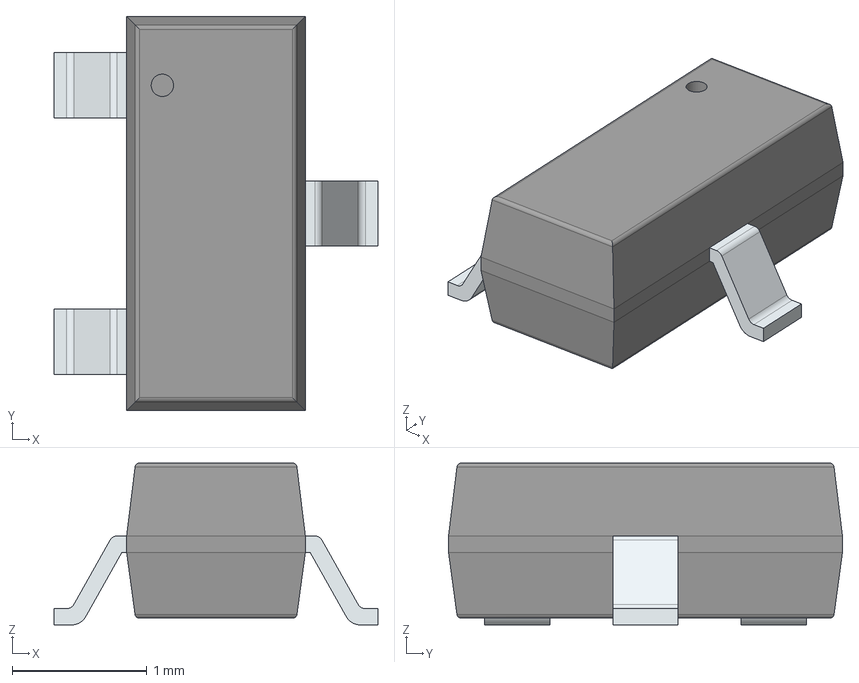
[picture p89: CAD file, 2025-05-17]
models/MMBT3904.step
2.40 x 2.92 x 1.20 mm
PinsArrayL
FilletPinR
