crgmakes/kicad-library/models/ATTINY1616-MFR.step

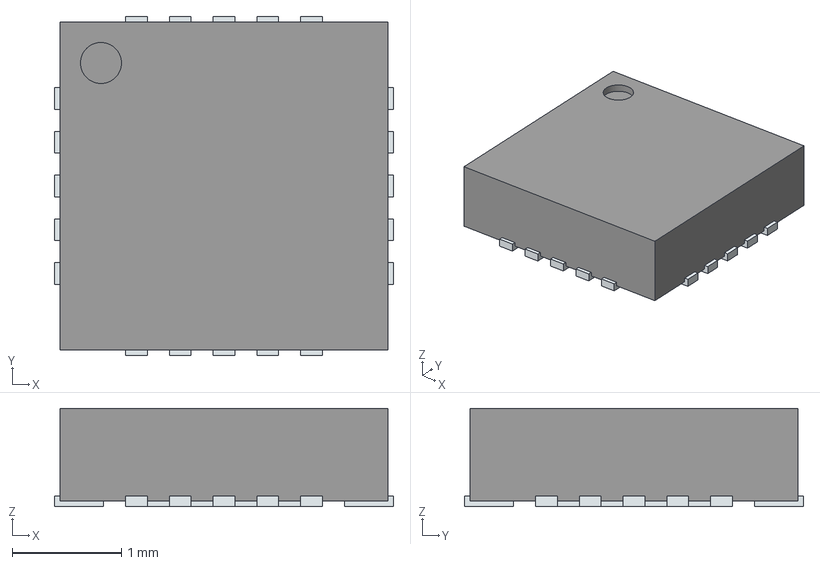
[picture p90: CAD file, 2025-05-17]
models/ATTINY1616-MFR.step
3.10 x 3.10 x 0.9 mm
ThermalPin
PinsArrayLR
PinsArrayTB
