crgmakes/kicad-library/models/CMT-0502-75-SMT-TR.step

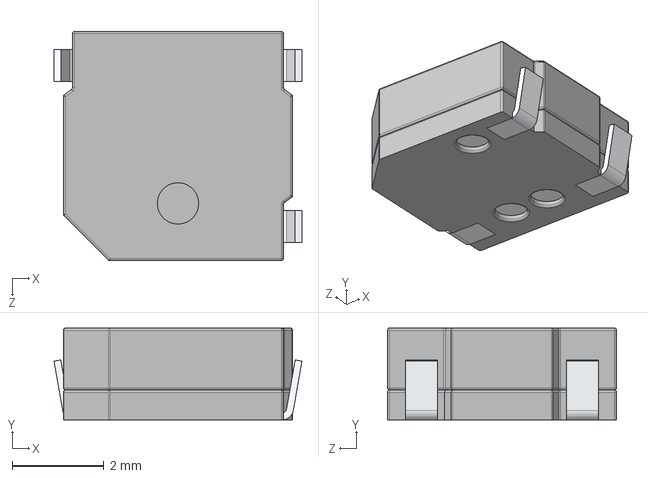
[picture p91: CAD file, 2025-05-17]
models/CMT-0502-75-SMT-TR.step
5.40 x 2.00 x 5.00 mm
