crgmakes/kicad-library/models/HC-PH-4ALT.step

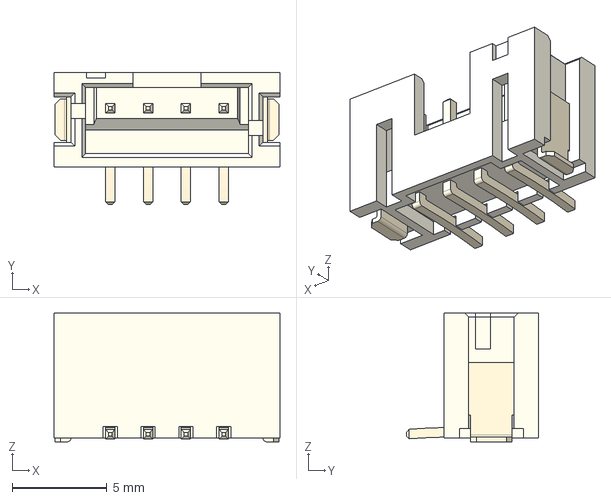
[picture p92: CAD file, 2025-05-17]
models/HC-PH-4ALT.step
11.9 x 7.00 x 6.80 mm
