crgmakes/kicad-library/models/WS2812-2020.step

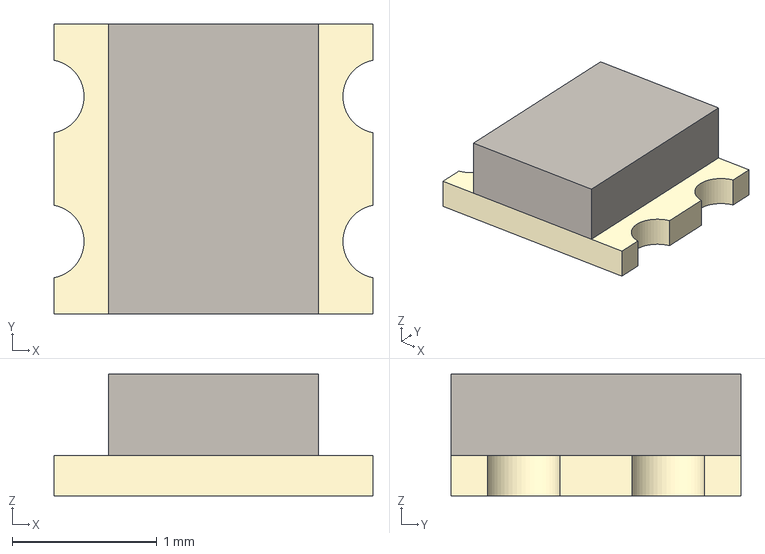
[picture p93: CAD file, 2025-05-17]
models/WS2812-2020.step
2.20 x 2.00 x 0.84 mm
