crgmakes/kicad-library/models/SM08B-SRSS-TB.step

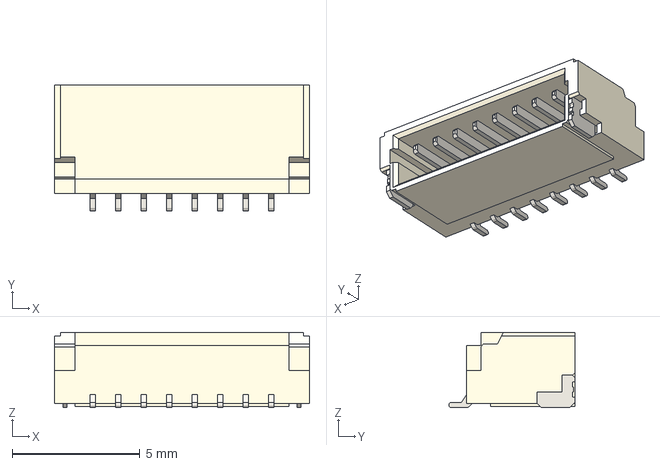
[picture p94: CAD file, 2025-05-17]
models/SM08B-SRSS-TB.step
10.0 x 4.95 x 2.95 mm
