crgmakes/kicad-library/models/V250LA40BP.step

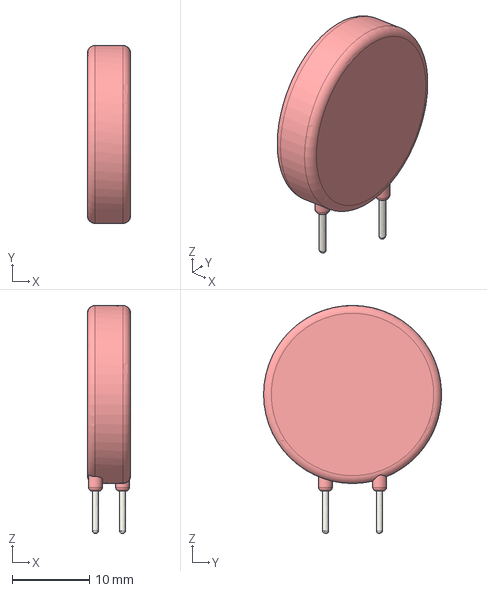
[picture p95: CAD file, 2025-05-17]
models/V250LA40BP.step
5.60 x 23.0 x 29.5 mm
