crgmakes/kicad-library/models/DNF1006-2.step

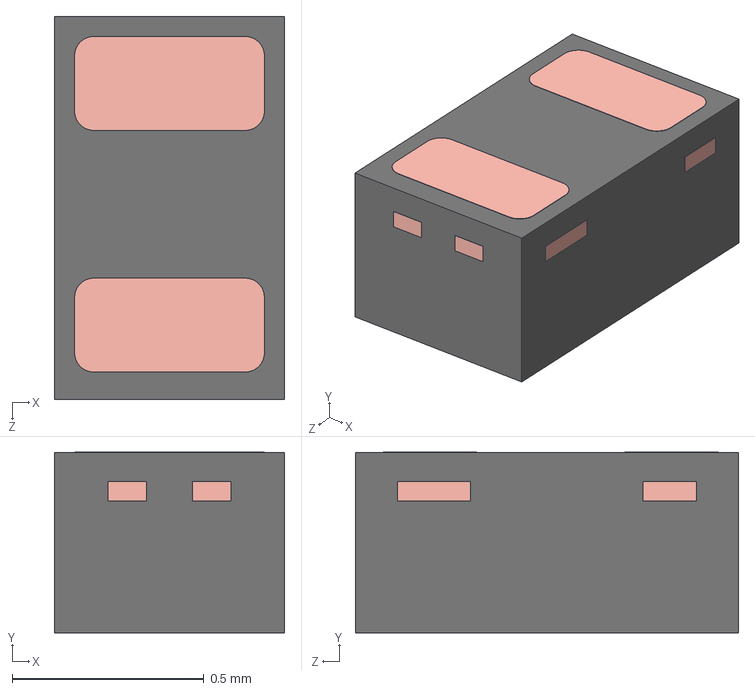
[picture p96: CAD file, 2025-05-17]
models/DNF1006-2.step
0.6 x 0.471 x 1.00 mm
SOD882 body
SOD882A3 singulated LF unit
