crgmakes/kicad-library/models/1.0K-BH-3PB.step

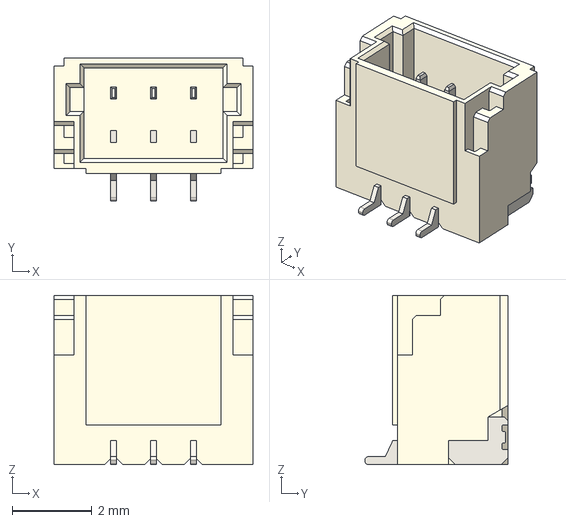
[picture p97: CAD file, 2025-05-17]
models/1.0K-BH-3PB.step
5.00 x 3.60 x 4.25 mm
