crgmakes/kicad-library/models/XF2C_1415-1A.step

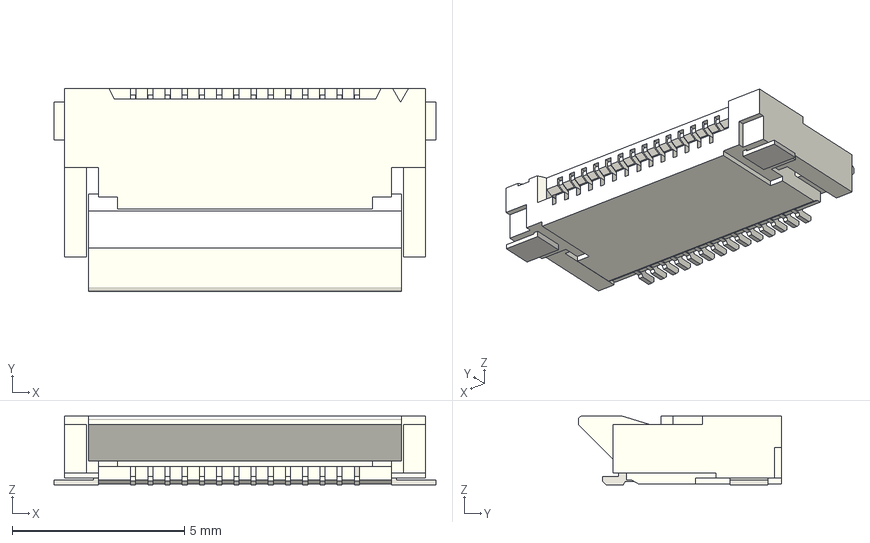
[picture p98: CAD file, 2025-05-17]
models/XF2C_1415-1A.step
11.1 x 5.90 x 2.00 mm
