crgmakes/kicad-library/models/BM02B-SRSS-TB.step

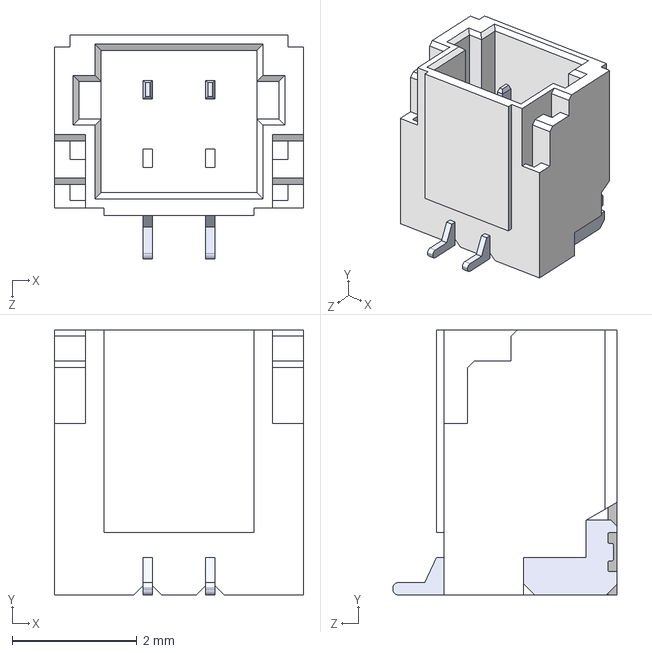
[picture p99: CAD file, 2025-05-17]
models/BM02B-SRSS-TB.step
4.00 x 4.25 x 3.60 mm
