crgmakes/kicad-library/models/LTV-817S.step

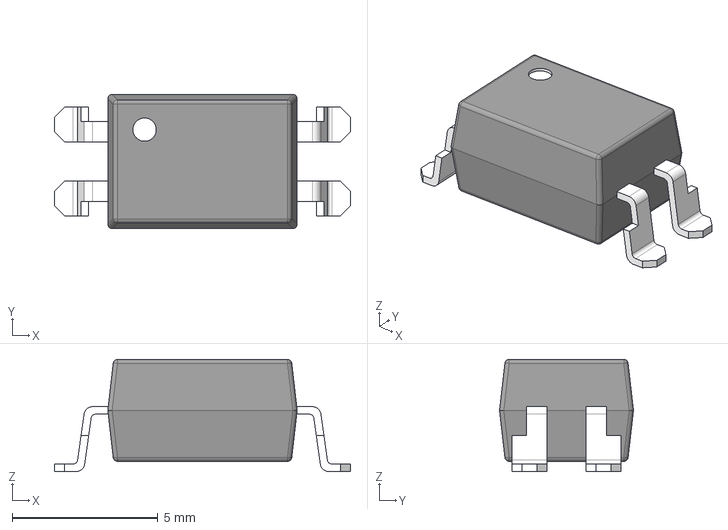
[picture p100: CAD file, 2025-05-17]
models/LTV-817S.step
10.2 x 4.60 x 3.85 mm
