crgmakes/kicad-library/(list of files, cad)

Other CAD files:
models/SM06B-SRSS-TB.step
models/BM04B-SRSS-TB.step
models/ESP32-S3-WROOM-1-N8R2.step
models/LM66200DRLR.step
models/SM02B-SRSS-TB.FCStd
models/SM06B-SRSS-TB.FCStd
models/TPS61023DRLR.step
