crgmakes/kicad-library/design_blocks/MCU.kicad_blocks/STM32C0 Reference.kicad_block/STM32C0 Reference.kicad_pcb

## KiCad design design_blocks/MCU.kicad_blocks/STM32C0 Reference.kicad_block/STM32C0 Reference.kicad_pcb (2026-09-18)

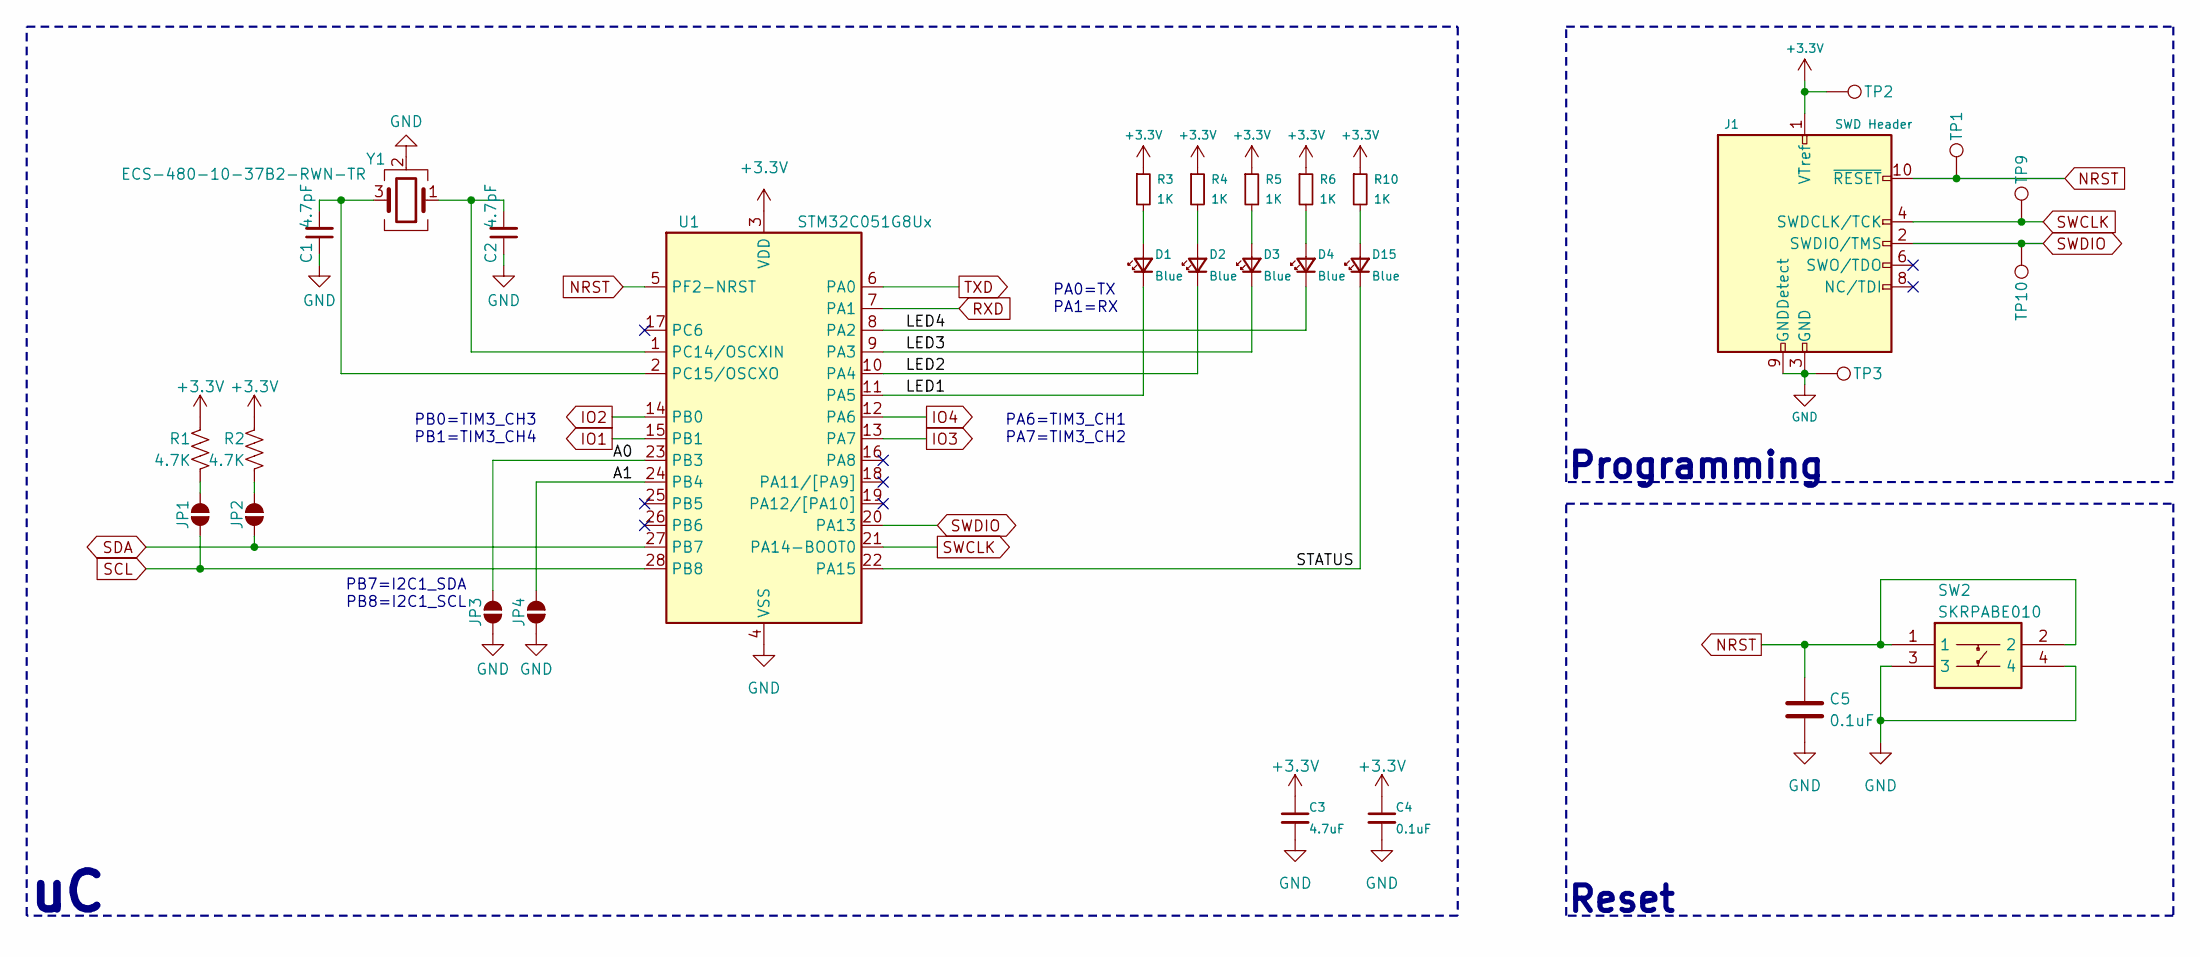
[picture p101: schematic STM32C0 Reference.kicad_sch]

Parts:
C1, C2: 4.7pF; C_0603_1608Metric; MPN FCC0603N4R7C500CT; Digikey 1276-1792-2-ND
C3: 4.7uF; C_0603_1608Metric; Tolerance 10%; MPN CL10A475KO8NNNC; Digikey 1276-1784-2-ND
C4: 0.1uF; C_0603_1608Metric; Tolerance 10%; MPN CL10B104KO8NNNC; Mouser 187-CL10B104KO8NNNC
C5: 0.1uF; C_0603_1608Metric; Tolerance 10%; MPN CL10B104KO8NNNC; Digikey 1276-1005-2-ND
D1, D2, D3, D4, D15: Blue; LED_0603_1608Metric; MPN XL-1608UBC-04; Digikey 5962-XL-1608UBC-04TR-ND
J1: SWD Header; PinHeader_2x05_P1.27mm_Vertical_SMD; MPN DZ127S-22-10-55; LCSC C5160761
JP1, JP2, JP3, JP4: SolderJumper_2_Open; SolderJumper-2_P1.3mm_Open_RoundedPad1.0x1.5mm
R1, R2: 4.7K; R_0603_1608Metric; Tolerance 5%; MPN FRC0603J472 TS; Mouser 71-CRCW06034K70JNEAC
R3, R4, R5, R6, R10: 1K; R_0603_1608Metric; Tolerance 5%; MPN FRC0603J102 TS; Mouser 71-CRCW06031K00JNEAC
SW2: SKRPABE010; SMD-4P-4.2x3.2mm; MPN SKRPABE010; Digikey 4809-SKRPABE010TR-ND
TP1, TP2, TP3, TP9, TP10: TestPoint_Pad_D1.0mm
U1: STM32C051G8Ux; QFN-28_4x4mm_P0.5mm; Digikey 497-STM32C051G8U6-ND
Y1: ECS-480-10-37B2-RWN-TR; Crystal_SMD_2016-4Pin_2.0x1.6mm; MPN ECS-480-10-37B2-RWN-TR; Digikey 50-ECS-480-10-37B2-RWN-TR-ND

Connections:
+3.3V: C3.1, C4.1, J1.1 (VTref), R1.2, R2.2, R3.1, R4.1, R5.1, R6.1, R10.1, TP2.1 (1_1), U1.3 (VDD)
/MCU/A0: JP3.2 (B), U1.23 (PB3)
/MCU/A1: JP4.2 (B), U1.24 (PB4)
/MCU/LED1: D1.1 (K), U1.11 (PA5)
/MCU/LED2: D2.1 (K), U1.10 (PA4)
/MCU/LED3: D3.1 (K), U1.9 (PA3)
/MCU/LED4: D4.1 (K), U1.8 (PA2)
/MCU/STATUS: D15.1 (K), U1.22 (PA15)
GND: C1.1, C2.1, C3.2, C4.2, C5.2, J1.3 (GND), J1.5 (GND), J1.9 (GNDDetect), JP3.1 (A), JP4.1 (A), TP3.1 (1_1), U1.4 (VSS), Y1.2 (G), Y1.4 (G); also elsewhere on the board
IO1: U1.15 (PB1)
IO2: U1.14 (PB0)
IO3: U1.13 (PA7)
IO4: U1.12 (PA6)
NRST: C5.1, J1.10 (~RESET), TP1.1 (1_1), U1.5 (PF2-NRST); also elsewhere on the board
unnamed: D1.2 (A), R3.2
unnamed: D2.2 (A), R4.2
unnamed: D3.2 (A), R5.2
unnamed: D4.2 (A), R6.2
unnamed: D15.2 (A), R10.2
unnamed: JP1.2 (B), R1.1
unnamed: JP2.2 (B), R2.1
unnamed: C2.2, U1.1 (PC14/OSCXIN), Y1.1
unnamed: C1.2, U1.2 (PC15/OSCXO), Y1.3
RXD: U1.7 (PA1)
SCL: JP1.1 (A), U1.28 (PB8)
SDA: JP2.1 (A), U1.27 (PB7)
SWCLK: J1.4 (SWDCLK/TCK), TP9.1 (1_1), U1.21 (PA14-BOOT0)
SWDIO: J1.2 (SWDIO/TMS), TP10.1 (1_1), U1.20 (PA13)
TXD: U1.6 (PA0)

Notes on the sheet:
PB0=TIM3_CH3 PB1=TIM3_CH4
PA6=TIM3_CH1 PA7=TIM3_CH2
Reset
Programming
PB7=I2C1_SDA PB8=I2C1_SCL
PA0=TX PA1=RX

Board: 4 copper layers, 30 parts (7 on the bottom side), 23 nets, no tracks yet.

Other parts of the board:
SW1: SKRPABE010; SMD-4P-4.2x3.2mm

Their connections:
GND: SW1.3, SW1.4; also elsewhere on the board
NRST: SW1.1, SW1.2; also elsewhere on the board
