crgmakes/kicad-library/design_blocks/Aquarius.kicad_blocks/Current Sensor v3.1 AC.kicad_block/Current Sensor v3.1 AC.kicad_pcb

## KiCad design design_blocks/Aquarius.kicad_blocks/Current Sensor v3.1 AC.kicad_block/Current Sensor v3.1 AC.kicad_pcb (2026-09-18)

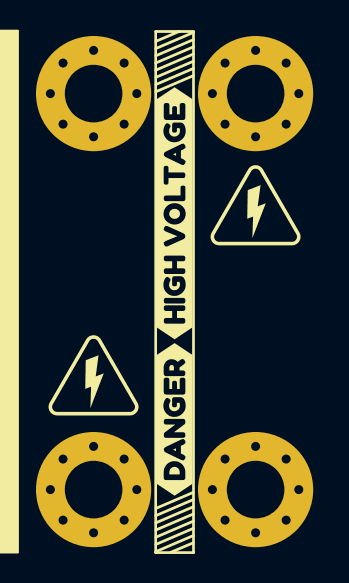
[picture p102: board Current Sensor v3.1 AC.kicad_pcb from above]

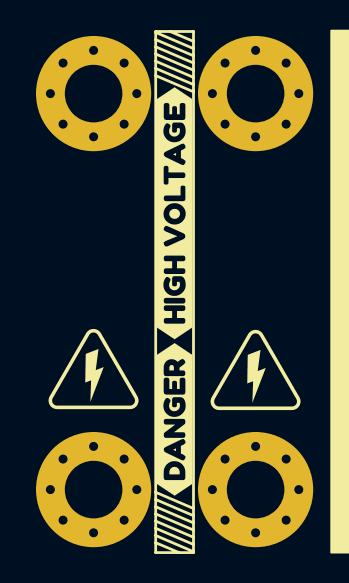
[picture p103: board Current Sensor v3.1 AC.kicad_pcb from below]

Board: 4 copper layers, 12 parts (4 on the bottom side), 2 nets, no tracks yet.

Parts:
H5, H6, H7, H8: MountingHole_3.2mm_M3_Pad_Via
SYM1, SYM2, SYM3, SYM4: HIGH-VOLTAGE-5MM
kibuzzard-68F7E62B: G***; kibuzzard-68F7E62B
kibuzzard-68F7E82B: G***; kibuzzard-68F7E82B
kibuzzard-68F7E620: G***; kibuzzard-68F7E620
kibuzzard-68F7E835: G***; kibuzzard-68F7E835

Connections:
/Power/Line: H5.1, H6.1
/Power/Neutral: H7.1, H8.1
