crgmakes/kicad-library/design_blocks/Aquarius.kicad_blocks/Current Sensor v3.1.kicad_block/Current Sensor v3.1.kicad_pcb

## KiCad design design_blocks/Aquarius.kicad_blocks/Current Sensor v3.1.kicad_block/Current Sensor v3.1.kicad_pcb (2026-09-18)

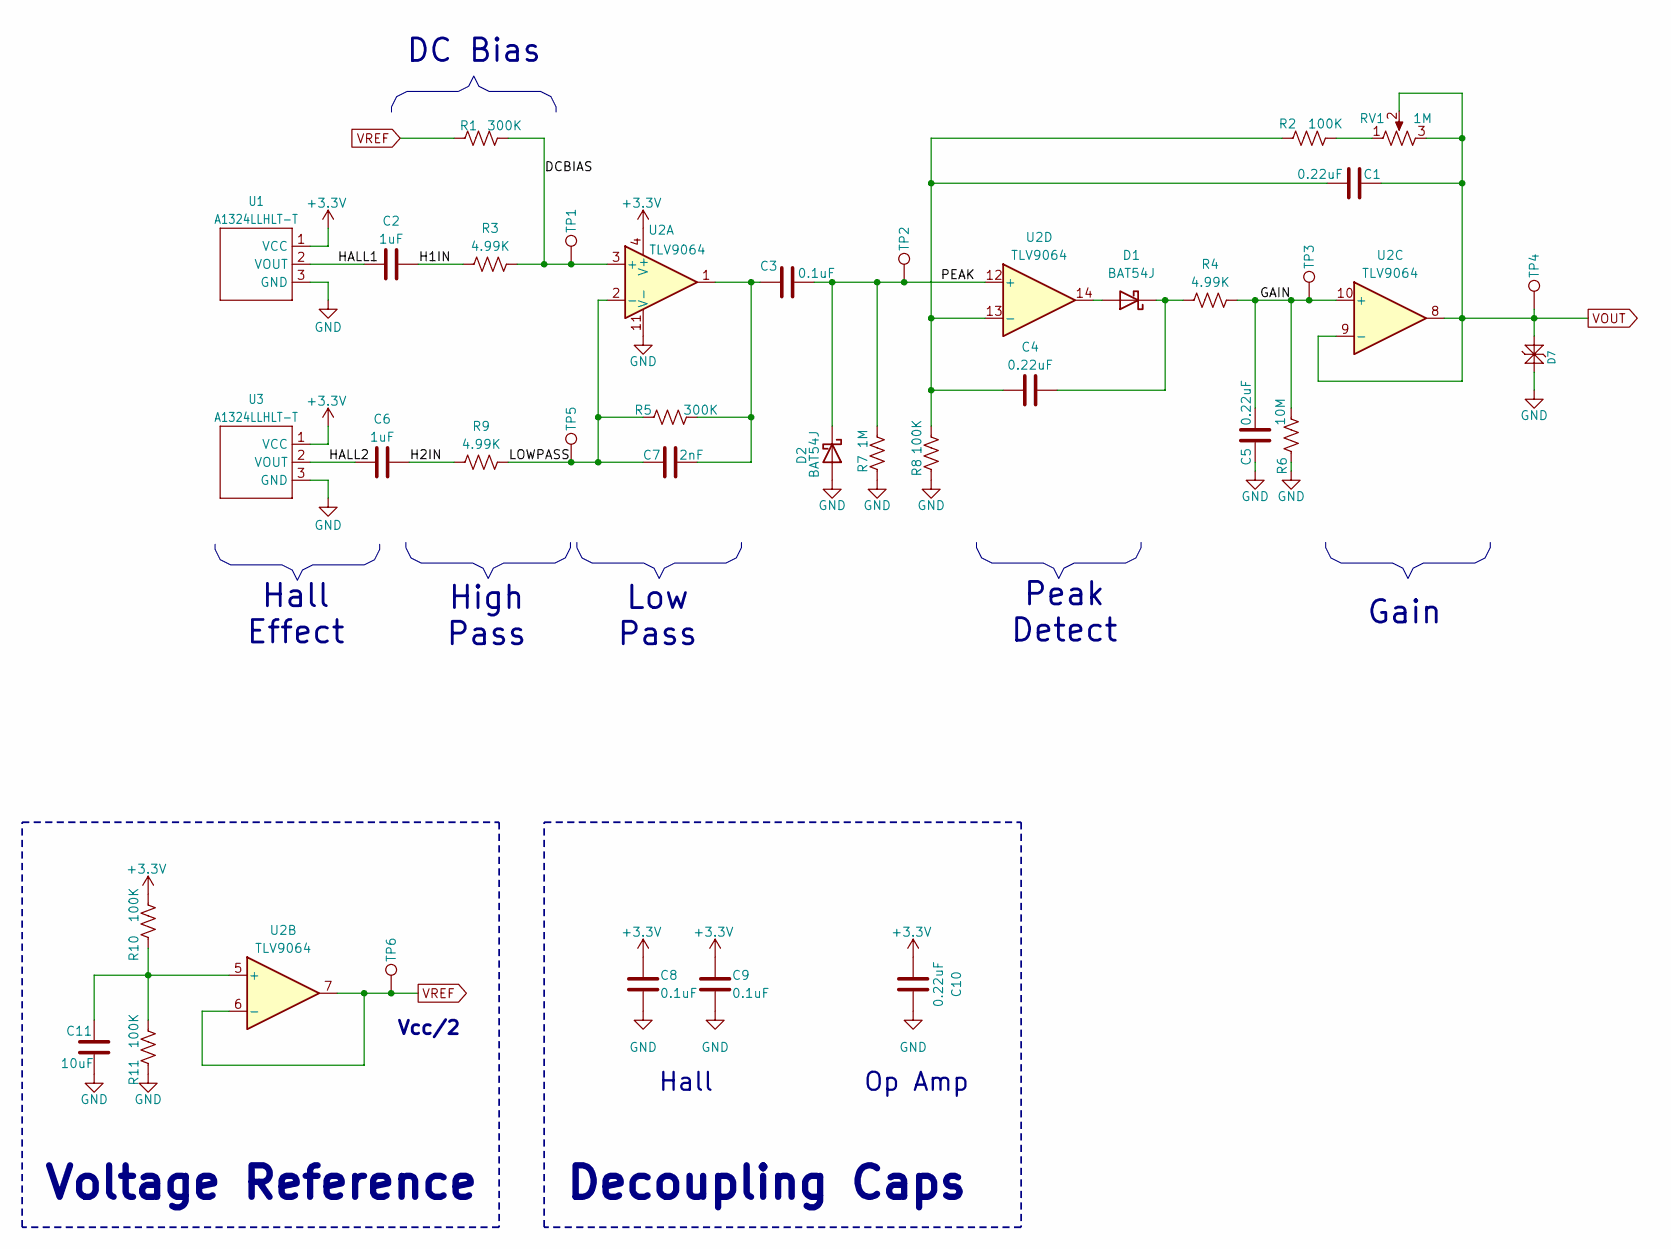
[picture p104: schematic Current Sensor v3.1.kicad_sch]

Parts:
C1, C4, C5, C10: 0.22uF; C_0603_1608Metric; Tolerance 10%; MPN CL10B224KA8NNNC; Mouser 603-CC603KRX7R8BB224
C2, C6: 1uF; C_0603_1608Metric; Tolerance 10%; MPN CGA0603X5R105K160JT; Digikey 1276-1019-2-ND
C3, C8, C9: 0.1uF; C_0603_1608Metric; Tolerance 10%; MPN CL10B104KO8NNNC; LCSC C66501
C7: 2nF; C_0603_1608Metric; Tolerance 10%; MPN CC0603KRX7R9BB202; Mouser 603-CC603KRX7R9BB202
C11: 10uF; C_0603_1608Metric; Tolerance 10%; MPN CL10A106MO8NQNC; Mouser 187-CL10A106MO8NQNC
D1, D2: BAT54J; D_SOD-323F; MPN BAT54J,115; Mouser 771-BAT54J115
D7: PESD3V3S1BL; DFN1006-2; MPN LESD8D3.3CAT5G; LCSC C5563754
R1, R5: 300K; R_0603_1608Metric; Tolerance 5%; MPN FRC0603F3003TS; Digikey CR0603-JW-304ELFTR-ND
R2, R8, R10, R11: 100K; R_0603_1608Metric; Tolerance 5%; MPN FRC0603F1003TS; Digikey CR0603-JW-104ELFTR-ND
R3, R4, R9: 4.99K; R_0603_1608Metric; Tolerance 1%; MPN FRC0603F4991TS; Digikey 541-4.99KHTR-ND
R6: 10M; R_0603_1608Metric; Tolerance 5%; MPN FRC0603J106 TS; Digikey CR0603-JW-106ELFTR-ND
R7: 1M; R_0603_1608Metric; Tolerance 5%; MPN FRC0603F1003TS; Digikey CR0603-JW-105ELFTR-ND
RV1: 1M; Bourns_TC33X_Vertical; Tolerance 25%; MPN TC33X-2-105E; Mouser 652-TC33X-2-105E
TP1, TP2, TP3, TP4, TP5, TP6: TestPoint_Pad_D1.0mm
U1, U3: A1324LLHLT-T; SOT23W; MPN A1324LLHLT-T; Mouser 250-A1324LLHLX-T
U2: TLV9064; SOIC-14_3.9x8.7mm_P1.27mm; MPN TLV9064IDR; Mouser 595-TLV9064IDR

Connections:
+3.3V: C8.1, C9.1, C10.1, R10.1, U1.1 (VCC), U2.4 (V+), U3.1 (VCC)
/Current Sensor/DCBIAS: R1.1, R3.1, TP1.1, U2.3 (+)
/Current Sensor/GAIN: C5.2, R4.1, R6.1, TP3.1, U2.10 (+)
/Current Sensor/H1IN: C2.2, R3.2
/Current Sensor/H2IN: C6.2, R9.2
/Current Sensor/HALL1: C2.1, U1.2 (VOUT)
/Current Sensor/HALL2: C6.1, U3.2 (VOUT)
/Current Sensor/LOWPASS: C7.1, R5.2, R9.1, TP5.1, U2.2 (-)
/Current Sensor/PEAK: C3.2, D2.1 (K), R7.1, TP2.1, U2.12 (+)
GND: C5.1, C8.2, C9.2, C10.2, C11.2, D2.2 (A), D7.1 (K1), R6.2, R7.2, R8.2, R11.2, U1.3 (GND), U2.11 (V-), U3.3 (GND)
unnamed: C3.1, C7.2, R5.1, U2.1
unnamed: D1.2 (A), U2.14
unnamed: C4.2, D1.1 (K), R4.2
unnamed: R2.1, RV1.1
unnamed: C11.1, R10.2, R11.1, U2.5 (+)
unnamed: C1.1, C4.1, R2.2, R8.1, U2.13 (-)
VOUT: C1.2, D7.2 (K2), RV1.2, RV1.3, TP4.1, U2.8, U2.9 (-)
VREF: R1.2, TP6.1, U2.6 (-), U2.7

Notes on the sheet:
High Pass
Hall Effect
DC Bias
Gain
Low Pass
Op Amp
Vcc/2
Decoupling Caps
Voltage Reference
Peak Detect
Hall

Board: 4 copper layers, 35 parts (6 on the bottom side), 18 nets, no tracks yet.
