crgmakes/kicad-library/design_blocks/Misc.kicad_blocks/Indicator LED - Blue.kicad_block/Indicator LED - Blue.kicad_sch

## KiCad design design_blocks/Misc.kicad_blocks/Indicator LED - Blue.kicad_block/Indicator LED - Blue.kicad_sch (2026-03-19)

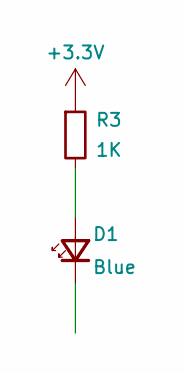
[picture p105: schematic Indicator LED - Blue.kicad_sch]

Parts:
D1: Blue; LED_0603_1608Metric; MPN XL-1608UBC-04; Mouser 859-LTST-C190TBKT
R3: 1K; R_0603_1608Metric; Tolerance 5%; MPN FRC0603J102 TS; Mouser 71-CRCW06031K00JNEAC

Connections:
+3.3V: R3.1
unnamed: D1.2 (A), R3.2
