crgmakes/kicad-library/design_blocks/Misc.kicad_blocks/Power LEDs - Blue.kicad_block/Power LEDs - Blue.kicad_sch

## KiCad design design_blocks/Misc.kicad_blocks/Power LEDs - Blue.kicad_block/Power LEDs - Blue.kicad_sch (2026-01-01)

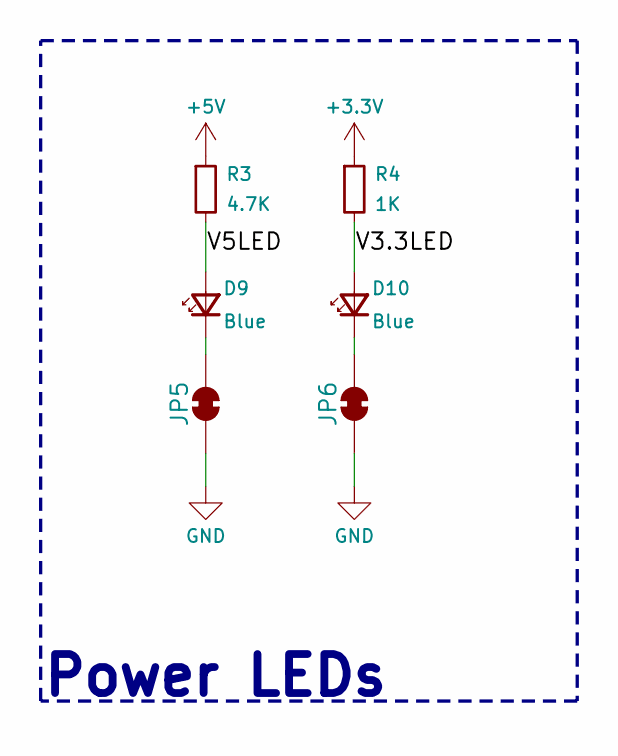
[picture p106: schematic Power LEDs - Blue.kicad_sch]

Parts:
D9, D10: Blue; LED_0603_1608Metric; MPN XL-1608UBC-04; Mouser 859-LTST-C190TBKT
JP5, JP6: SolderJumper-2_P1.3mm_Bridged_RoundedPad1.0x1.5mm
R3: 4.7K; R_0603_1608Metric; Tolerance 5%; MPN FRC0603J472 TS; Mouser 71-CRCW06034K70JNEAC
R4: 1K; R_0603_1608Metric; Tolerance 5%; MPN FRC0603J102 TS; Mouser 71-CRCW06031K00JNEAC

Connections:
+3.3V: R4.1
+5V: R3.1
GND: JP5.1 (A), JP6.1 (A)
unnamed: D9.1 (K), JP5.2 (B)
unnamed: D10.1 (K), JP6.2 (B)
V3.3LED: D10.2 (A), R4.2
V5LED: D9.2 (A), R3.2

Notes on the sheet:
Power LEDs
