crgmakes/kicad-library/design_blocks/Misc.kicad_blocks/Power LEDs - Orange.kicad_block/Power LEDs - Orange.kicad_sch

## KiCad design design_blocks/Misc.kicad_blocks/Power LEDs - Orange.kicad_block/Power LEDs - Orange.kicad_sch (2025-10-22)

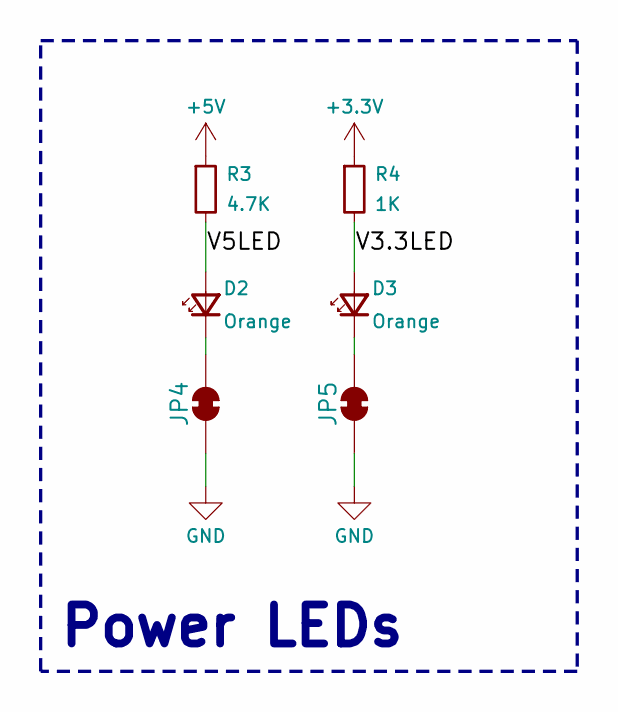
[picture p107: schematic Power LEDs - Orange.kicad_sch]

Parts:
D2, D3: Orange; LED_0603_1608Metric; MPN XL-1608UOC-06; Mouser 859-LTST-C190KFKT
JP4: SolderJumper-2_P1.3mm_Bridged_RoundedPad1.0x1.5mm
JP5: (no value)
R3: 4.7K; R_0603_1608Metric; MPN FRC0603J472 TS; Mouser 71-CRCW06034K70JNEAC
R4: 1K; R_0603_1608Metric; MPN CRCW06031K00FKEA; Mouser 71-CRCW06031K00JNEAC

Connections:
+3.3V: R4.1
+5V: R3.1
GND: JP4.1 (A), JP5.1 (A)
unnamed: D2.1 (K), JP4.2 (B)
unnamed: D3.1 (K), JP5.2 (B)
V3.3LED: D3.2 (A), R4.2
V5LED: D2.2 (A), R3.2

Notes on the sheet:
Power LEDs
