crgmakes/kicad-library/design_blocks/Misc.kicad_blocks/Power LEDs.kicad_block/Power LEDs.kicad_sch

## KiCad design design_blocks/Misc.kicad_blocks/Power LEDs.kicad_block/Power LEDs.kicad_sch (2025-08-11)

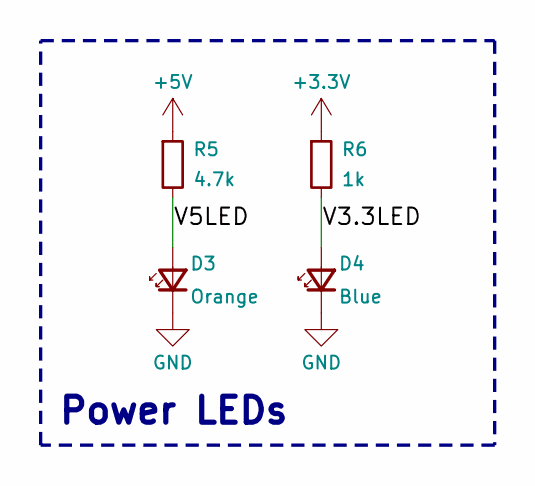
[picture p108: schematic Power LEDs.kicad_sch]

Parts:
D3: Orange; LED_0603_1608Metric; MPN XL-1608UOC-06; Mouser 859-LTST-C190KFKT
D4: Blue; LED_0603_1608Metric; MPN XL-1608UBC-04; Mouser 710-150060BS75020
R5: 4.7k; R_0603_1608Metric; MPN FRC0603J472 TS; Mouser 71-CRCW06034K70JNEAC
R6: 1k; R_0603_1608Metric; MPN CRCW06031K00FKEA; Mouser 71-CRCW0603-1.0K-E3

Connections:
+3.3V: R6.1
+5V: R5.1
GND: D3.1 (K), D4.1 (K)
V3.3LED: D4.2 (A), R6.2
V5LED: D3.2 (A), R5.2

Notes on the sheet:
Power LEDs
