crgmakes/kicad-library/design_blocks/Misc.kicad_blocks/SW with Cap.kicad_block/SW with Cap.kicad_sch

## KiCad design design_blocks/Misc.kicad_blocks/SW with Cap.kicad_block/SW with Cap.kicad_sch (2026-06-10)

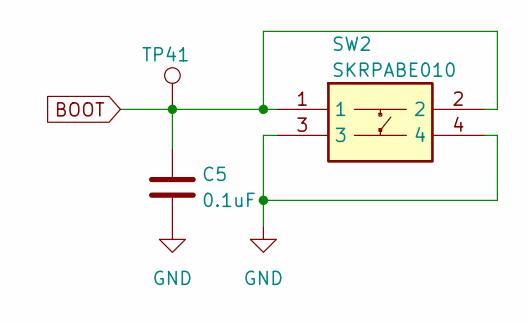
[picture p109: schematic SW with Cap.kicad_sch]

Parts:
C5: 0.1uF; C_0603_1608Metric; Tolerance 10%; MPN CL10B104KO8NNNC; Digikey 1276-1005-2-ND
SW2: SKRPABE010; SMD-4P-4.2x3.2mm; MPN SKRPABE010; Digikey 4809-SKRPABE010TR-ND
TP41: TestPoint_Pad_D1.0mm

Connections:
BOOT: C5.1, SW2.1, SW2.2, TP41.1
GND: C5.2, SW2.3, SW2.4
