crgmakes/kicad-library/design_blocks/Misc.kicad_blocks/SW with Pull Up.kicad_block/SW with Pull Up.kicad_sch

## KiCad design design_blocks/Misc.kicad_blocks/SW with Pull Up.kicad_block/SW with Pull Up.kicad_sch (2026-06-10)

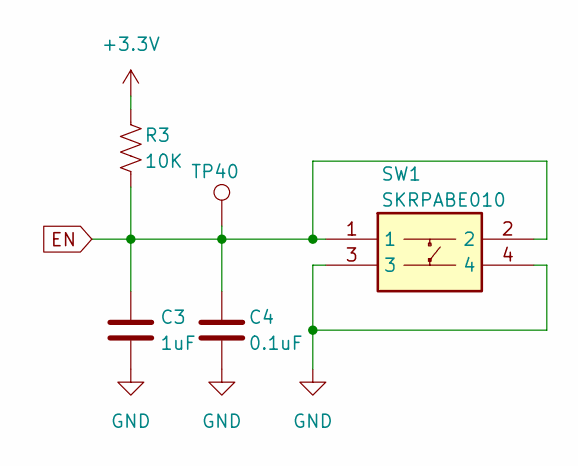
[picture p110: schematic SW with Pull Up.kicad_sch]

Parts:
C3: 1uF; C_0603_1608Metric; Tolerance 10%; MPN CL10B105KO8NNNC; Mouser 187-CL10B105KO8NNNC
C4: 0.1uF; C_0603_1608Metric; Tolerance 10%; MPN CL10B104KO8NNNC; Mouser 187-CL10B104KO8NNNC
R3: 10K; R_0603_1608Metric; Tolerance 5%; MPN FRC0603J103TS; Mouser 652-CR0603-JW-103ELF
SW1: SKRPABE010; SMD-4P-4.2x3.2mm; MPN SKRPABE010; Digikey 4809-SKRPABE010TR-ND
TP40: TestPoint_Pad_D1.0mm

Connections:
+3.3V: R3.1
EN: C3.1, C4.1, R3.2, SW1.1, SW1.2, TP40.1
GND: C3.2, C4.2, SW1.3, SW1.4
