crgmakes/kicad-library/design_blocks/Power.kicad_blocks/Power Bulk Decoupling.kicad_block/Power Bulk Decoupling.kicad_sch

## KiCad design design_blocks/Power.kicad_blocks/Power Bulk Decoupling.kicad_block/Power Bulk Decoupling.kicad_sch (2026-03-19)

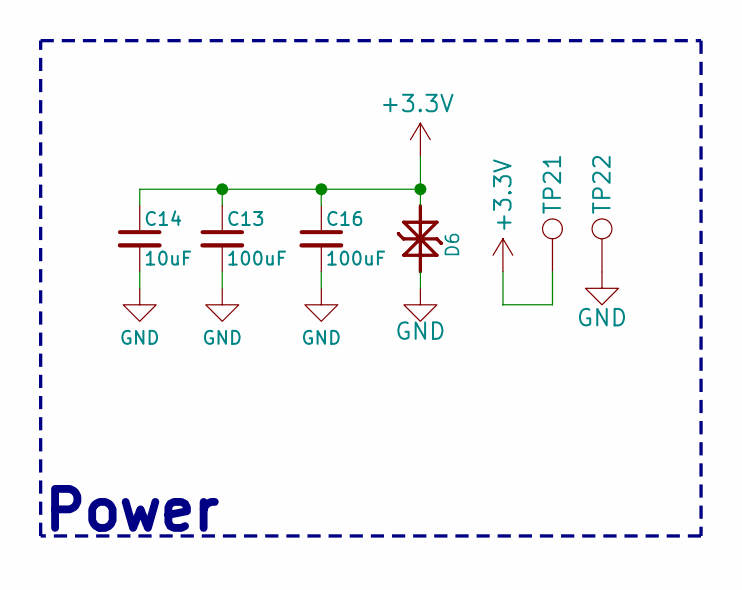
[picture p111: schematic Power Bulk Decoupling.kicad_sch]

Parts:
C13, C16: 100uF; C_1206_3216Metric; Tolerance 20%; MPN CL31A107MQHNNNE; Digikey 1276-1782-2-ND
C14: 10uF; C_0603_1608Metric; Tolerance 10%; MPN CL10A106MO8NQNC; Mouser 187-CL10A106MO8NQNC
D6: PESD3V3S1BL; DFN1006-2; MPN LESD8D3.3CAT5G; LCSC C5563754
TP21, TP22: TestPoint_Pad_D1.0mm

Connections:
+3.3V: C13.1, C14.1, C16.1, D6.2 (K2), TP21.1
GND: C13.2, C14.2, C16.2, D6.1 (K1), TP22.1

Notes on the sheet:
Power
