crgmakes/kicad-library/design_blocks/Power.kicad_blocks/Power Filter, 5VDC.kicad_block/Power Filter, 5VDC.kicad_sch

## KiCad design design_blocks/Power.kicad_blocks/Power Filter, 5VDC.kicad_block/Power Filter, 5VDC.kicad_sch (2025-06-02)

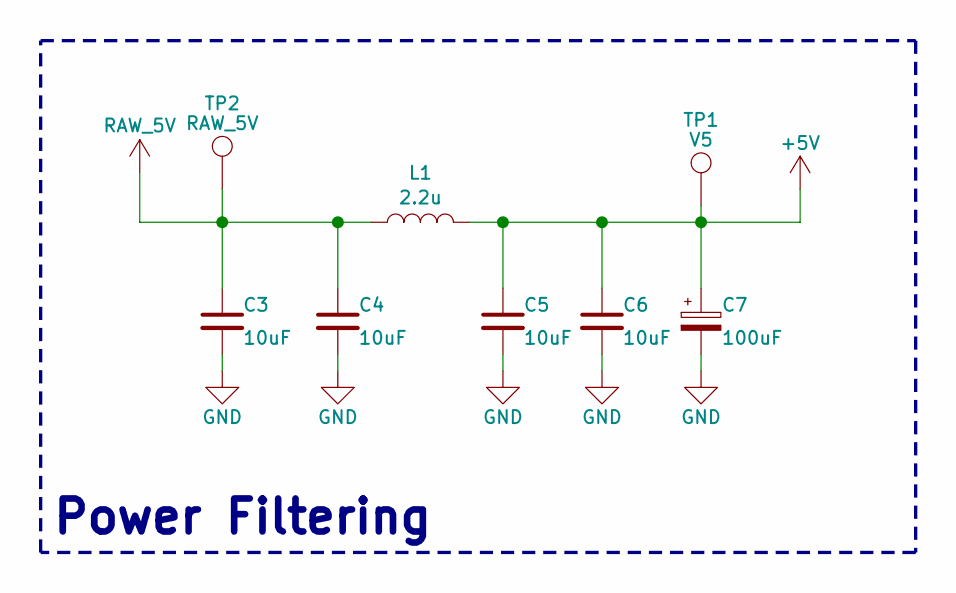
[picture p112: schematic Power Filter, 5VDC.kicad_sch]

Parts:
C3, C4, C5, C6: 10uF; C_0603_1608Metric; MPN CL10A106MO8NQNC; Mouser 187-CL10A106MO8NQNC
C7: 100uF; CP_Elec_6.3x7.7; MPN RVT1V101M0607; Mouser 647-UWT1V101MCL1S
L1: 2.2u; L_Sunlord_MWSA0402S; MPN CMLO0420H2R2MTT; Mouser 673-PA4332222NLT
TP1: V5; TestPoint_Pad_D1.0mm
TP2: RAW_5V; TestPoint_Pad_D1.0mm

Connections:
+5V: C5.1, C6.1, C7.1, L1.2, TP1.1
GND: C3.2, C4.2, C5.2, C6.2, C7.2
RAW_5V: C3.1, C4.1, L1.1, TP2.1

Notes on the sheet:
Power Filtering
