crgmakes/kicad-library/design_blocks/Power.kicad_blocks/Power, Filtering, 5VDC.kicad_block/Power, Filtering, 5VDC.kicad_sch

## KiCad design design_blocks/Power.kicad_blocks/Power, Filtering, 5VDC.kicad_block/Power, Filtering, 5VDC.kicad_sch (2025-05-17)

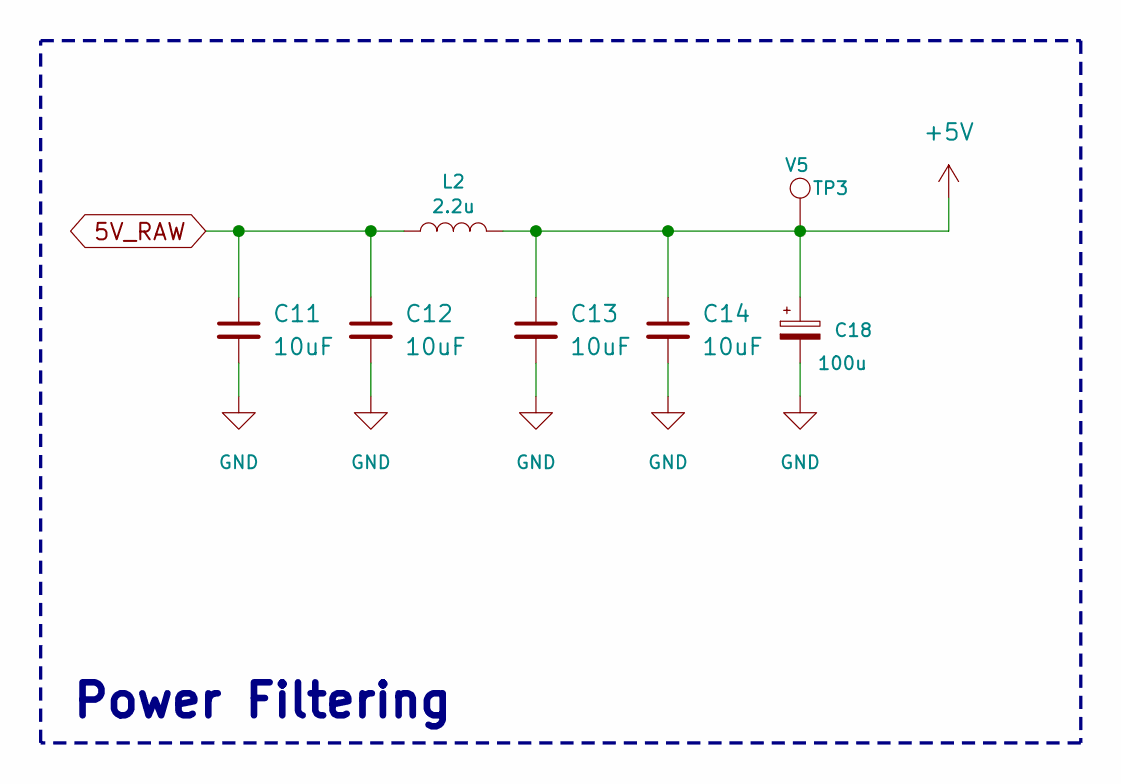
[picture p113: schematic Power, Filtering, 5VDC.kicad_sch]

Parts:
C11, C12, C13, C14: 10uF; C_0603_1608Metric; MPN CL10A106MO8NQNC; LCSC C92487
C18: 100u; CP_Elec_6.3x7.7; JLCPCB C3339
L2: 2.2u; L_Sunlord_MWSA0402S; MPN MWSA0402S-2R2MT; JLCPCB C408335
TP3: V5; TestPoint_Pad_D2.0mm

Connections:
5V_RAW: C11.1, C12.1, L2.1
+5V: C13.1, C14.1, C18.1, L2.2, TP3.1
GND: C11.2, C12.2, C13.2, C14.2, C18.2

Notes on the sheet:
Power Filtering
