crgmakes/kicad-library/design_blocks/Power.kicad_blocks/Power, LDO, 3.3VDC, 0.8A.kicad_block/Power, LDO, 3.3VDC, 0.8A.kicad_sch

## KiCad design design_blocks/Power.kicad_blocks/Power, LDO, 3.3VDC, 0.8A.kicad_block/Power, LDO, 3.3VDC, 0.8A.kicad_sch (2025-05-17)

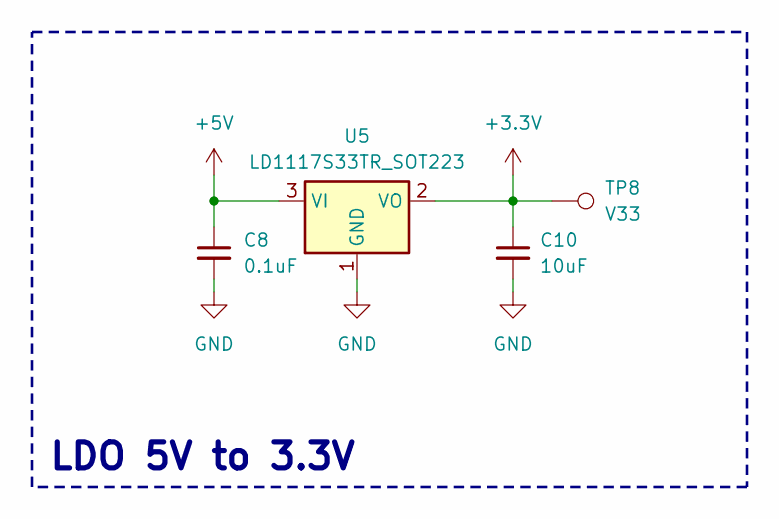
[picture p114: schematic Power, LDO, 3.3VDC, 0.8A.kicad_sch]

Parts:
C8: 0.1uF; C_0603_1608Metric; MPN CL10B104KO8NNNC; LCSC C66501
C10: 10uF; C_0603_1608Metric; MPN CL10A106MO8NQNC; LCSC C92487
TP8: V33; TestPoint_Pad_D1.0mm
U5: LD1117S33TR_SOT223; SOT-223-3_TabPin2; MPN LD1117S33TR; LCSC_PN C86781

Connections:
+3.3V: C10.1, TP8.1, U5.2 (VO)
+5V: C8.1, U5.3 (VI)
GND: C8.2, C10.2, U5.1 (GND)

Notes on the sheet:
LDO 5V to 3.3V
