crgmakes/kicad-library/design_blocks/Power.kicad_blocks/Power, LDO, 3.3VDC, 3A.kicad_block/Power, LDO, 3.3VDC, 3A.kicad_sch

## KiCad design design_blocks/Power.kicad_blocks/Power, LDO, 3.3VDC, 3A.kicad_block/Power, LDO, 3.3VDC, 3A.kicad_sch (2025-06-02)

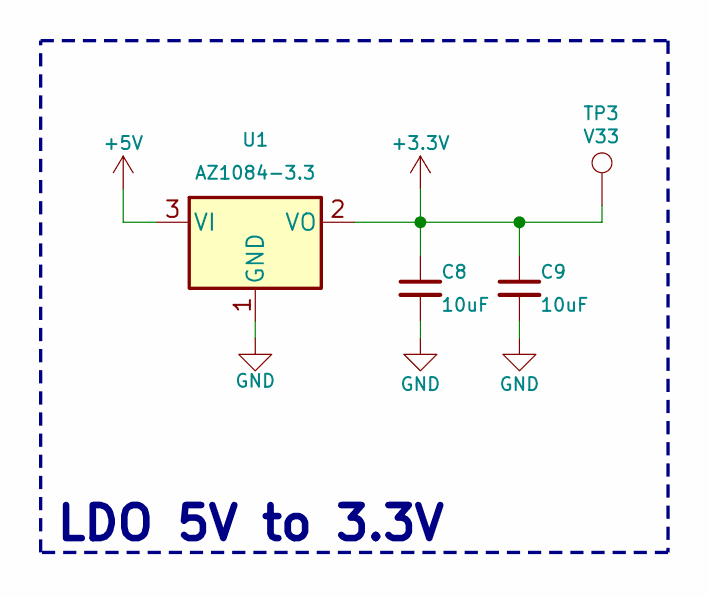
[picture p115: schematic Power, LDO, 3.3VDC, 3A.kicad_sch]

Parts:
C8, C9: 10uF; C_0603_1608Metric; MPN CL10A106MO8NQNC; Mouser 187-CL10A106MO8NQNC
TP3: V33; TestPoint_Pad_D1.0mm
U1: AZ1084-3.3; TO-252-2; MPN AZ1084CD-3.3TRG1; Mouser 621-AZ1084CD-3.3TRG1

Connections:
+3.3V: C8.1, C9.1, TP3.1, U1.2 (VO)
+5V: U1.3 (VI)
GND: C8.2, C9.2, U1.1 (GND)

Notes on the sheet:
LDO 5V to 3.3V
