crgmakes/kicad-library/design_blocks/Power.kicad_blocks/Power, Source, 120VAC IN, 5VDC 2A Out.kicad_block/Power, Source, 120VAC IN, 5VDC 2A Out.kicad_sch

## KiCad design design_blocks/Power.kicad_blocks/Power, Source, 120VAC IN, 5VDC 2A Out.kicad_block/Power, Source, 120VAC IN, 5VDC 2A Out.kicad_sch (2025-05-17)

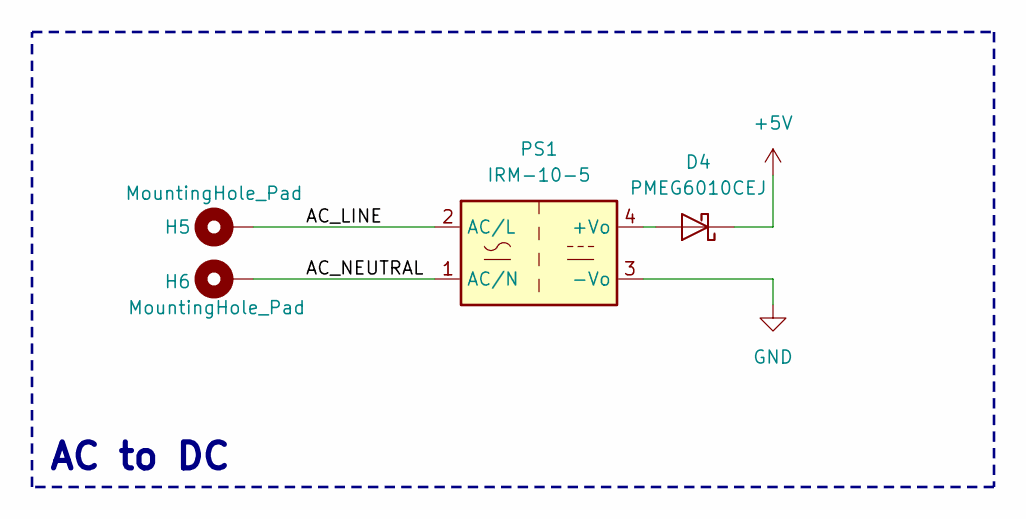
[picture p116: schematic Power, Source, 120VAC IN, 5VDC 2A Out.kicad_sch]

Parts:
D4: PMEG6010CEJ; D_SOD-323; MPN PMEG6010CEJ; LCSC C27636122
H5, H6: MountingHole_Pad
PS1: IRM-10-5; Converter_ACDC_MeanWell_IRM-10-xx_THT; LCSC C2857903

Connections:
+5V: D4.1 (K)
AC_LINE: H5.1, PS1.2 (AC/L)
AC_NEUTRAL: H6.1, PS1.1 (AC/N)
GND: PS1.3 (-Vo)
unnamed: D4.2 (A), PS1.4 (+Vo)

Notes on the sheet:
AC to DC
