crgmakes/kicad-library/design_blocks/Power.kicad_blocks/Power, Source, USB-C In, 5VDC Out.kicad_block/Power, Source, USB-C In, 5VDC Out.kicad_sch

## KiCad design design_blocks/Power.kicad_blocks/Power, Source, USB-C In, 5VDC Out.kicad_block/Power, Source, USB-C In, 5VDC Out.kicad_sch (2025-05-17)

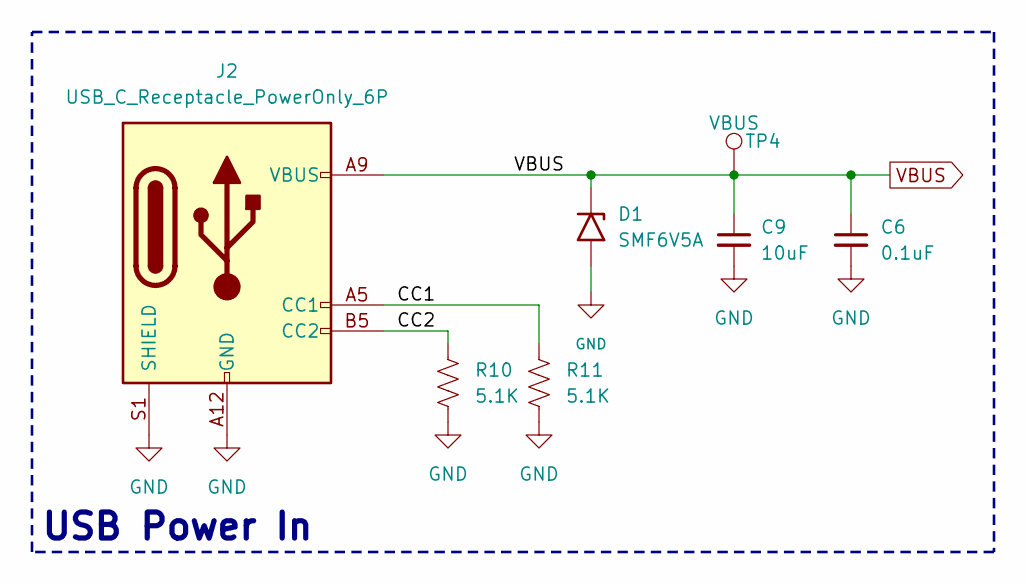
[picture p117: schematic Power, Source, USB-C In, 5VDC Out.kicad_sch]

Parts:
C6: 0.1uF; C_0603_1608Metric; MPN CL10B104KO8NNNC; LCSC C66501
C9: 10uF; C_0603_1608Metric; MPN CL10A106MO8NQNC; LCSC C92487
D1: SMF6V5A; D_SOD-123F; MPN SMF6.5A; LCSC C2943842
J2: USB_C_Receptacle_PowerOnly_6P; USB_C_Receptacle_GCT_USB4105-xx-A_16P_TopMnt_Horizontal; MPN USB4105-GF-A-120; LCSC C5184243
R10, R11: 5.1K; R_0603_1608Metric; MPN FRC0603J512 TS; LCSC C2907114
TP4: VBUS; TestPoint_Pad_D1.0mm

Connections:
CC1: J2.A5 (CC1), R11.1
CC2: J2.B5 (CC2), R10.1
GND: C6.2, C9.2, D1.2 (A2), J2.A12 (GND), J2.B12 (GND), J2.S1 (SHIELD), R10.2, R11.2
VBUS: C6.1, C9.1, D1.1 (A1), J2.A9 (VBUS), J2.B9 (VBUS), TP4.1

Notes on the sheet:
USB Power In
