crgmakes/kicad-library/design_blocks/Power.kicad_blocks/USB-C Data.kicad_block/USB-C Data.kicad_sch

## KiCad design design_blocks/Power.kicad_blocks/USB-C Data.kicad_block/USB-C Data.kicad_sch (2025-08-11)

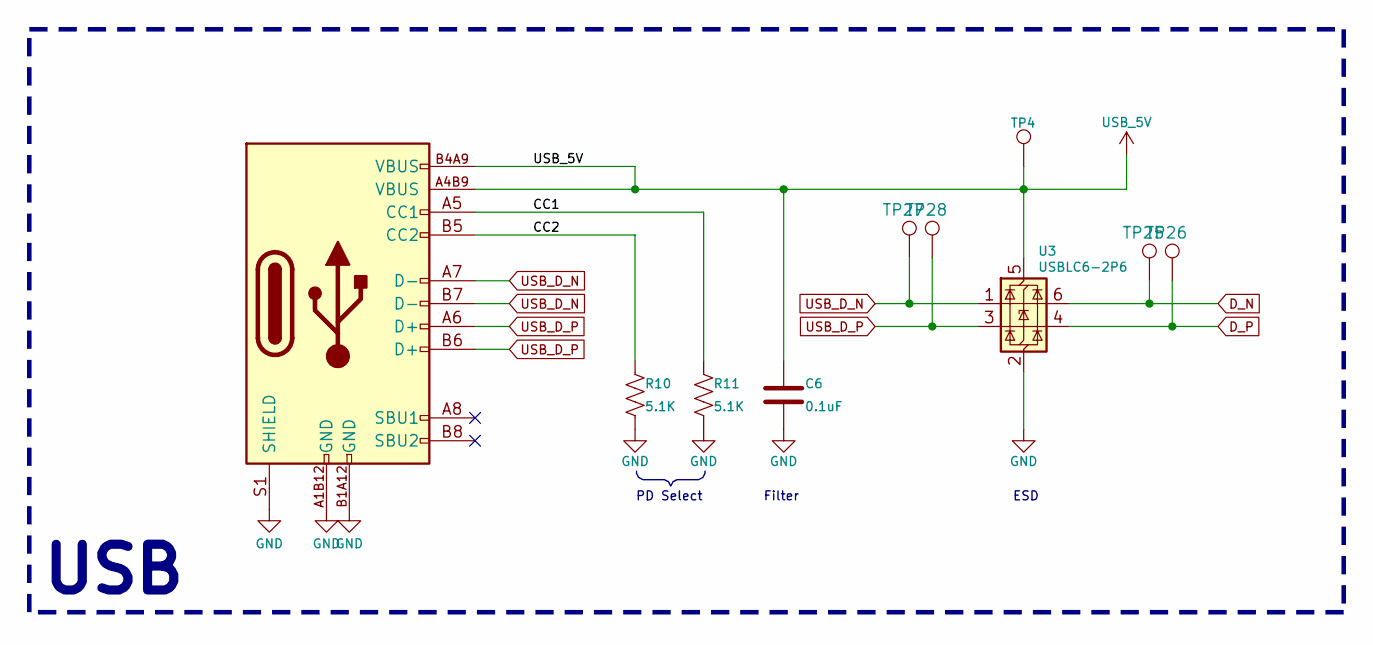
[picture p118: schematic USB-C Data.kicad_sch]

Parts:
C6: 0.1uF; C_0603_1608Metric; MPN CL10B104KO8NNNC; LCSC C66501
J2: USB_C_USB2.0_16P; GCT_USB4105-GF-A; MPN USB4105-GF-A-060; Mouser 640-USB4105-GF-A-060
R10, R11: 5.1K; R_0603_1608Metric; MPN FRC0603J512 TS; Mouser 652-CR0603JW-512ELF
TP4, TP25, TP26, TP27, TP28: TP; TestPoint_Pad_D1.0mm
U3: USBLC6-2P6; SOT-666; MPN USBLC6-2P6; LCSC C2827693

Connections:
CC1: J2.A5 (CC1), R11.1
CC2: J2.B5 (CC2), R10.1
D_N: TP25.1, U3.6 (I/O1)
D_P: TP26.1, U3.4 (I/O2)
GND: C6.2, J2.A1B12 (GND), J2.B1A12 (GND), J2.S1 (SHIELD), R10.2, R11.2, U3.2 (GND)
USB_5V: C6.1, J2.A4B9 (VBUS), J2.B4A9 (VBUS), TP4.1, U3.5 (VBUS)
USB_D_N: J2.A7 (D-), J2.B7 (D-), TP27.1, U3.1 (I/O1)
USB_D_P: J2.A6 (D+), J2.B6 (D+), TP28.1, U3.3 (I/O2)

Notes on the sheet:
USB
Filter
PD Select
ESD
