crgmakes/kicad-library/(commit log)

2025-05-17 Initial checkin of library files
    [1.0K-BH-3PB.step, ATTINY1616-MFR.stp, Aquarius, Module Base.kicad_sch, BM02B-SRSS-TB.STEP, BM03B-SRSS-TB.step, BM04B-SRSS-TB.step, BM06B-SRSS-TB.step, BM08B-SRSS-TB.STEP]
2025-05-20 updated module to adjust origins.
    [BM04B-SRSS-TB-orig.step, IRM-10-5-orig.step, IRM-10-5.step, LM66200DRLR-orig.stp, LM66200DRLR.step, SM04B-SRSS-TB-orig.step, TO-252-3_6P6X6P1_DIO-orig.step, TO-252-3_6P6X6P1_DIO.step]
2025-05-26 updated footprints for kicad positions
2025-05-29 Added soldermask to pins
2025-06-02 Added additional parts; fixed origin of other parts
    Added new design blocks
    [BM03B-SRSS-TB.step, BM04B-SRSS-TB-orig.step, BM04B-SRSS-TB.step, BM06B-SRSS-TB.step, BM08B-SRSS-TB.STEP, MMBT2222AT-7-F.step, Power Filter, 5VDC.kicad_sch, Power Selection, 5V.kicad_sch]
2025-06-07 updated ESP32-S3 footprint attributes
2025-06-09 Added UDPI Symbol and 2x3 SMD footprint
2025-06-21 Pulled some footprints into CRM
2025-06-21 Added mounting holes
2025-06-23 added 8mm logos
2025-06-26 Updated frame template
2025-06-28 Updated footprints for DFM; added FUET and XF2M
2025-07-12 renames models for consistency; deleted unused models
    [ATTINY1616-MFR.step, CMT-0502-75-SMT-TR.step, DNF1006-2.step, HDC1080DMBR.step, IRM-10-5-orig.step, LM66200DRLR-orig.stp, LTR-303ALS-01.step, SM04B-SRSS-TB-orig.step]
2025-07-24 Updated license; added foot prints and 3d models
    [LD1117S33TR.step]
2025-08-11 Moved stock parts to CRGM libraries
    [Aquarius, Module Base.kicad_sch, ESP32-S3 WROOM Reference.kicad_sch, ESP32-S3-WROOM-1-N8R2.step, HDC1080DMBR.step, LD1117S33TR.step, Module MCU.kicad_sch, Module Power Connectors.kicad_sch, Module Power Select.kicad_sch]
2025-08-12 added symbol and footprint for VOC sensor
2025-08-12 Removed unused footprints; fixed models for many components
    [SGP40-D-R4.step]
2025-08-14 Added 3.5mm CRGM logo
2025-08-15 Added Bourns Pot
    [TC33X-2-103E-Rot.step, TC33X-2-105E.step]
2025-08-16 fixed axis
    [SM03B-SRSS-TB.step]
2025-08-16 Added 0603 Resistor and Capacitor
2025-08-16 Fixed pot model and footprint
    [TC33X-2-103E.step, TC33X-2-105E.step]
2025-08-23 Fixed footprint on LED block; added Roxy 6.5
    [Module Power Select.kicad_sch, Power LEDs - Orange.kicad_sch]
2025-08-25 Added LED, Bourns, SOD-323, SOT-23
2025-08-26 Fixed default models; fixed USBLC6
    [USBLC6-2P6.step]
2025-08-31 Fixed rotation of TO-242; added SRX883 and STX883
    [SRX883Pro.step, STX883Pro.step, TO-252-3_6P6X6P1_DIO.step]
2025-10-22 Updated blocks
    Added current sensor
    Updated LEDs
    Updated QWICC
    Changed MCU
    [Current Sensor.kicad_sch, Module MCU Block.kicad_sch, Module QWICC Conenctors.kicad_sch, Module Serial Connector.kicad_sch, Module UPDI Header.kicad_sch, Power LEDs - Orange.kicad_sch]
2025-10-24 Added i2c switch
    [PCA9545APW.step, SOP65P640X110-20N.step]
2025-10-28 Added JST SH BM06
    Fixed model for BM03
    Added 4.2x3.2 switch
    [SKRPABE010.step, SM06B-SRSS-TB.FCStd, SM06B-SRSS-TB.step]
2025-11-02 Changed pin 1 indicator on SON80 footprint
2025-11-04 Added AHT20
    Added BAT48 model
    DFM updates
    [AHT20.step, BAT48JFILM.step]
2025-11-04 Fixed model on SGP40
    Updated silkscreen line width to be 0.15mm min
2025-11-05 Updated footprints for DFM
2025-11-25 added 1206 capacitor footprint
2025-12-16 Added new footprints
    Added 6.3x54. electrolytic cap
    Added Sunlord Inductor
2025-12-29 Added foot print for opto-isolator
    Added symbol for opto-isolator
    Added symbol for open jumper
2026-01-01 Added new blocks and footprints
    Added Blue LED power blokc
    Added 2.0mm pitch jumper
    Added 5x5.4 Cap
    Added SM02B model
    Updated DFN1006 to have ref designator on fab layer
    [Power LEDs - Blue.kicad_sch, SM02B-SRSS-TB.FCStd, SM02B-SRSS-TB.step]
2026-01-01 Updated silkscreen on 2.0mm jumper
2026-01-02 Created new logo sizes
    Aquarius 3.5mm
    Roxy 4mm
2026-02-03 Added new UPDI UART symbol
2026-03-06 Made mounting points ground enabled
2026-03-06 Renamed step files to lower case
    [BM02B-SRSS-TB.step, BM08B-SRSS-TB.step]
2026-03-06 Added N16R2 model
    [ESP32-S3-WROOM-1-N16R2.step]
2026-03-06 Updated model for ESP32-N16
    removed wrl file
    removed filter for esp32
2026-03-12 Updated footprints
2026-03-12 Changed footprint for LDO
2026-03-12 Validated footprints
2026-03-19 Added design blocks and model
    [A1324LLHLT-T.step, Indicator LED - Blue.kicad_sch, Module QWICC Dual.kicad_sch, Module UPDI and Serial.kicad_sch, Power Bulk Decoupling.kicad_sch]
2026-03-20 Updated A1324 origin
    Updated SOT23W model path
    [A1324LLHLT-T.step]
2026-03-22 Updated ATTINY1616 footprint
2026-04-15 Fixed attribute for UPDI footprint
2026-05-28 Cleaned JST SH02 and DFM1006
    Changed JST SH02 symbol point to CRGM Connectors
2026-06-10 Added new blocks, c_small, smt32c0
    [SW with Cap.kicad_sch, SW with Pull Up.kicad_sch]
2026-06-10 Added SOD-882 model; default for DFN1006-2
    [D_SOD-882.step]
2026-06-10 Added common models and added parts
    [CP_Elec_5x5.4.step, CP_Elec_6.3x5.4.step, C_0603_1608Metric.step, C_1206_3216Metric.step, JST_SH_BM02B-SRSS-TB_1x02-1MP_P1.00mm_Vertical.step, JST_SH_BM03B-SRSS-TB_1x03-1MP_P1.00mm_Vertical.step, JST_SH_BM04B-SRSS-TB_1x04-1MP_P1.00mm_Vertical.step, JST_SH_BM05B-SRSS-TB_1x05-1MP_P1.00mm_Vertical.step]
2026-06-13 Added more footprints and symbols
    QFN-20-4x4
    Pin Header 1.27 2x05
    Crystal 1612
    Crystal 2016
    Models for crystal and SMT32C0
    [ECS-480-8-47-JTN-TR.step, STM32C031G4U6.step]
2026-06-13 Fixed path; added Crystal model
    [Crystal_SMD_2016-4Pin_2.0x1.6mm.step]
2026-06-17 Added new models
    [D_SOD-323F.step, SOIC-14_3.9x8.7mm_P1.27mm.step]
2026-07-14 Added caps 1206 1210 0805 and models
    [C_0402_1005Metric.step, C_0805_2012Metric.step, C_1210_3225Metric.step]
2026-07-30 Updated esp32 and usb conn
2026-08-04 Added STM32C051G8U6
2026-08-05 added 2x2 pin model
    [PinHeader_2x02_P1.27mm_Vertical_SMD.step]
2026-09-03 Fixed aq power symbol
    modded LED 2x02, and 2x05 connector
    Added UFQFN28
2026-09-18 Added design blocks; updated silkscreen
    [Current Sensor v3.1 AC.kicad_pcb, Current Sensor v3.1 AC.kicad_sch, Current Sensor v3.1.kicad_pcb, Current Sensor v3.1.kicad_sch, IO with Bulk Filtering.kicad_sch, STM32C0 Reference.kicad_pcb, STM32C0 Reference.kicad_sch]
