crgmakes/kicad-library/(notices)

Notices in the files:
models/CP_Elec_6.3x5.4.step:
Copyright (C) 2018, kicad StepUp
This work is licensed under the [Creative Commons CC-BY-SA 4.0 License](https://creativecommons.org/licenses/by-sa/4.0/legalcode),
with the following exception:
To the extent that the creation of electronic designs that use 'Licensed Material' can be considered to be 'Adapted Material',
You are free to use the library data in your own projects without the obligation to share your project files under this or any other license agreement.
models/C_1206_3216Metric.step:
Copyright (C) 2017, kicad StepUp
models/D_SOD-323F.step:
This program is free software: you can redistribute it and/or modify
it under the terms of the GNU General Public License as published by
the Free Software Foundation, either version 3 of the License, or
any later version.
itself might be covered by the GNU General Public License.
models/D_SOD-882.step:
Copyright (C) 2024, KiCAD
This work is licensed under the
[Creative Commons CC-BY-SA 4.0 License](https://creativecommons.org/licenses/by-sa/4.0/legalcode),
project files under this or any other license agreement. However, if you wish to distribute
models/SOIC-14_3.9x8.7mm_P1.27mm.step:
Copyright (C) 2025, KiCAD
